mc2-coruna/LACNLC-PistaBaile/Previos Pista Baile/Pista de baile/Montaje.jpg

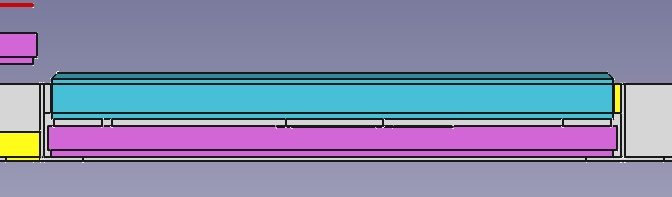
Previos Pista Baile/Pista de baile/Montaje.jpg
