mc2-coruna/LACNLC-PistaBaile/Previos Pista Baile/Pista de baile/Montaje.tif

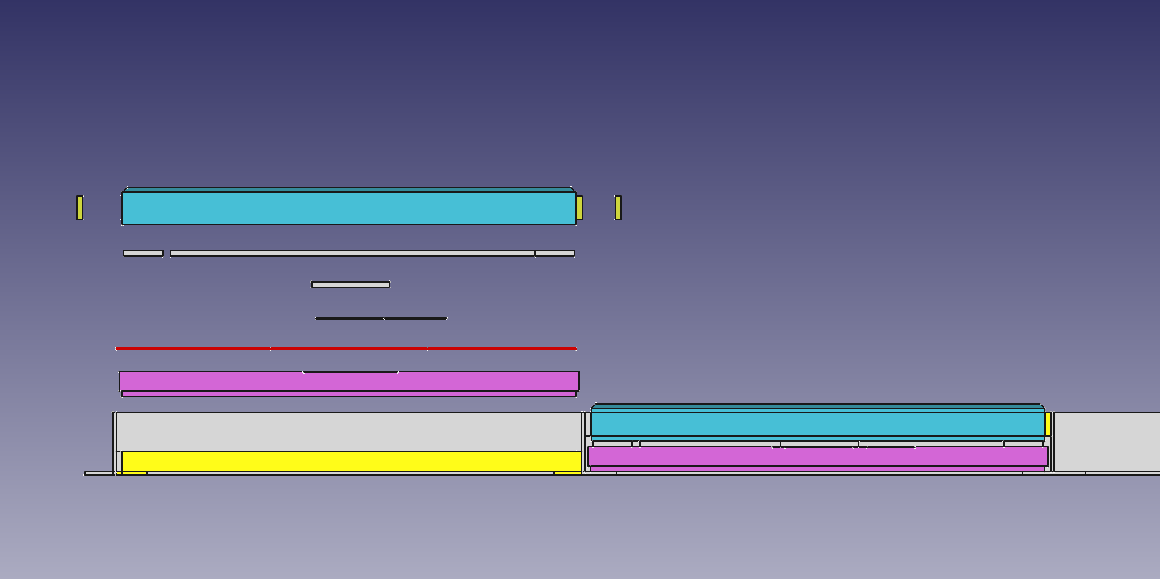
Previos Pista Baile/Pista de baile/Montaje.tif
