mc2-coruna/LACNLC-PistaBaile/README.md

# PistaBaile
Módulo bailón detector de rayos cósmicos
