mc2-coruna/LACNLC-PistaBaile/• Pista Baile_final/Detector_Rayos_Cosmicos/Referencias Detectores Geiger.md

Hodoscopio de 18 tubos: http://www.hardhack.org.au/cosmic_ray_telescope

Un poco de teoría: http://hardhack.org.au/book/export/html/2
        http://www.gae.ucm.es/fisica/report.html

No estamos solos: Detector realizado en Makespace Madrid: http://www.manualsupervivenciamaker.com/manual/inspiracion_electronica_detector_audiovisual_de_radiactividad.html

Página de compra tubos Geiger: Russian Geiger Counter CI-22G SI-22G.pdf
Página de compra fuente de alimentación Geiger: Geiger counter power supply module .pdf
