mc2-coruna/LACNLC-PistaBaile/Previos Pista Baile/Pista de baile/Plano ranura.pdf

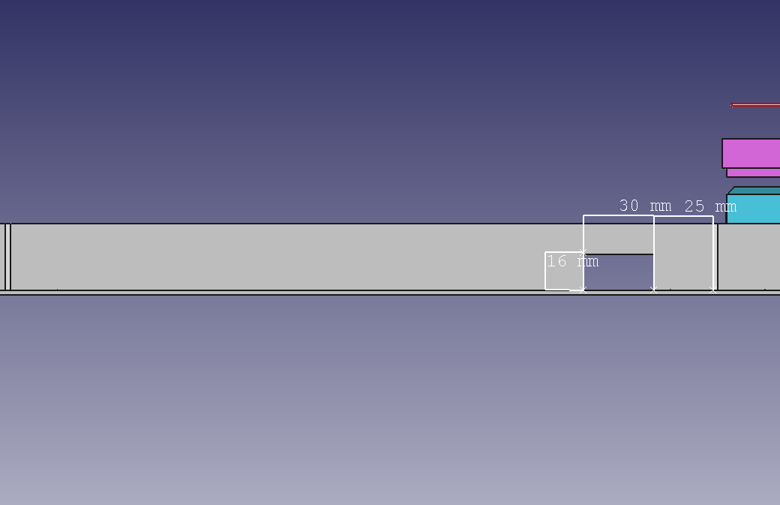
[picture p3: page 1]
