mc2-coruna/LACNLC-PistaBaile/• Pista Baile_final/Arduino/Módulo Bluetooth HC-05 configuración Master_Slave a través de Arduino Nano. - Crisalctime.pdf

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

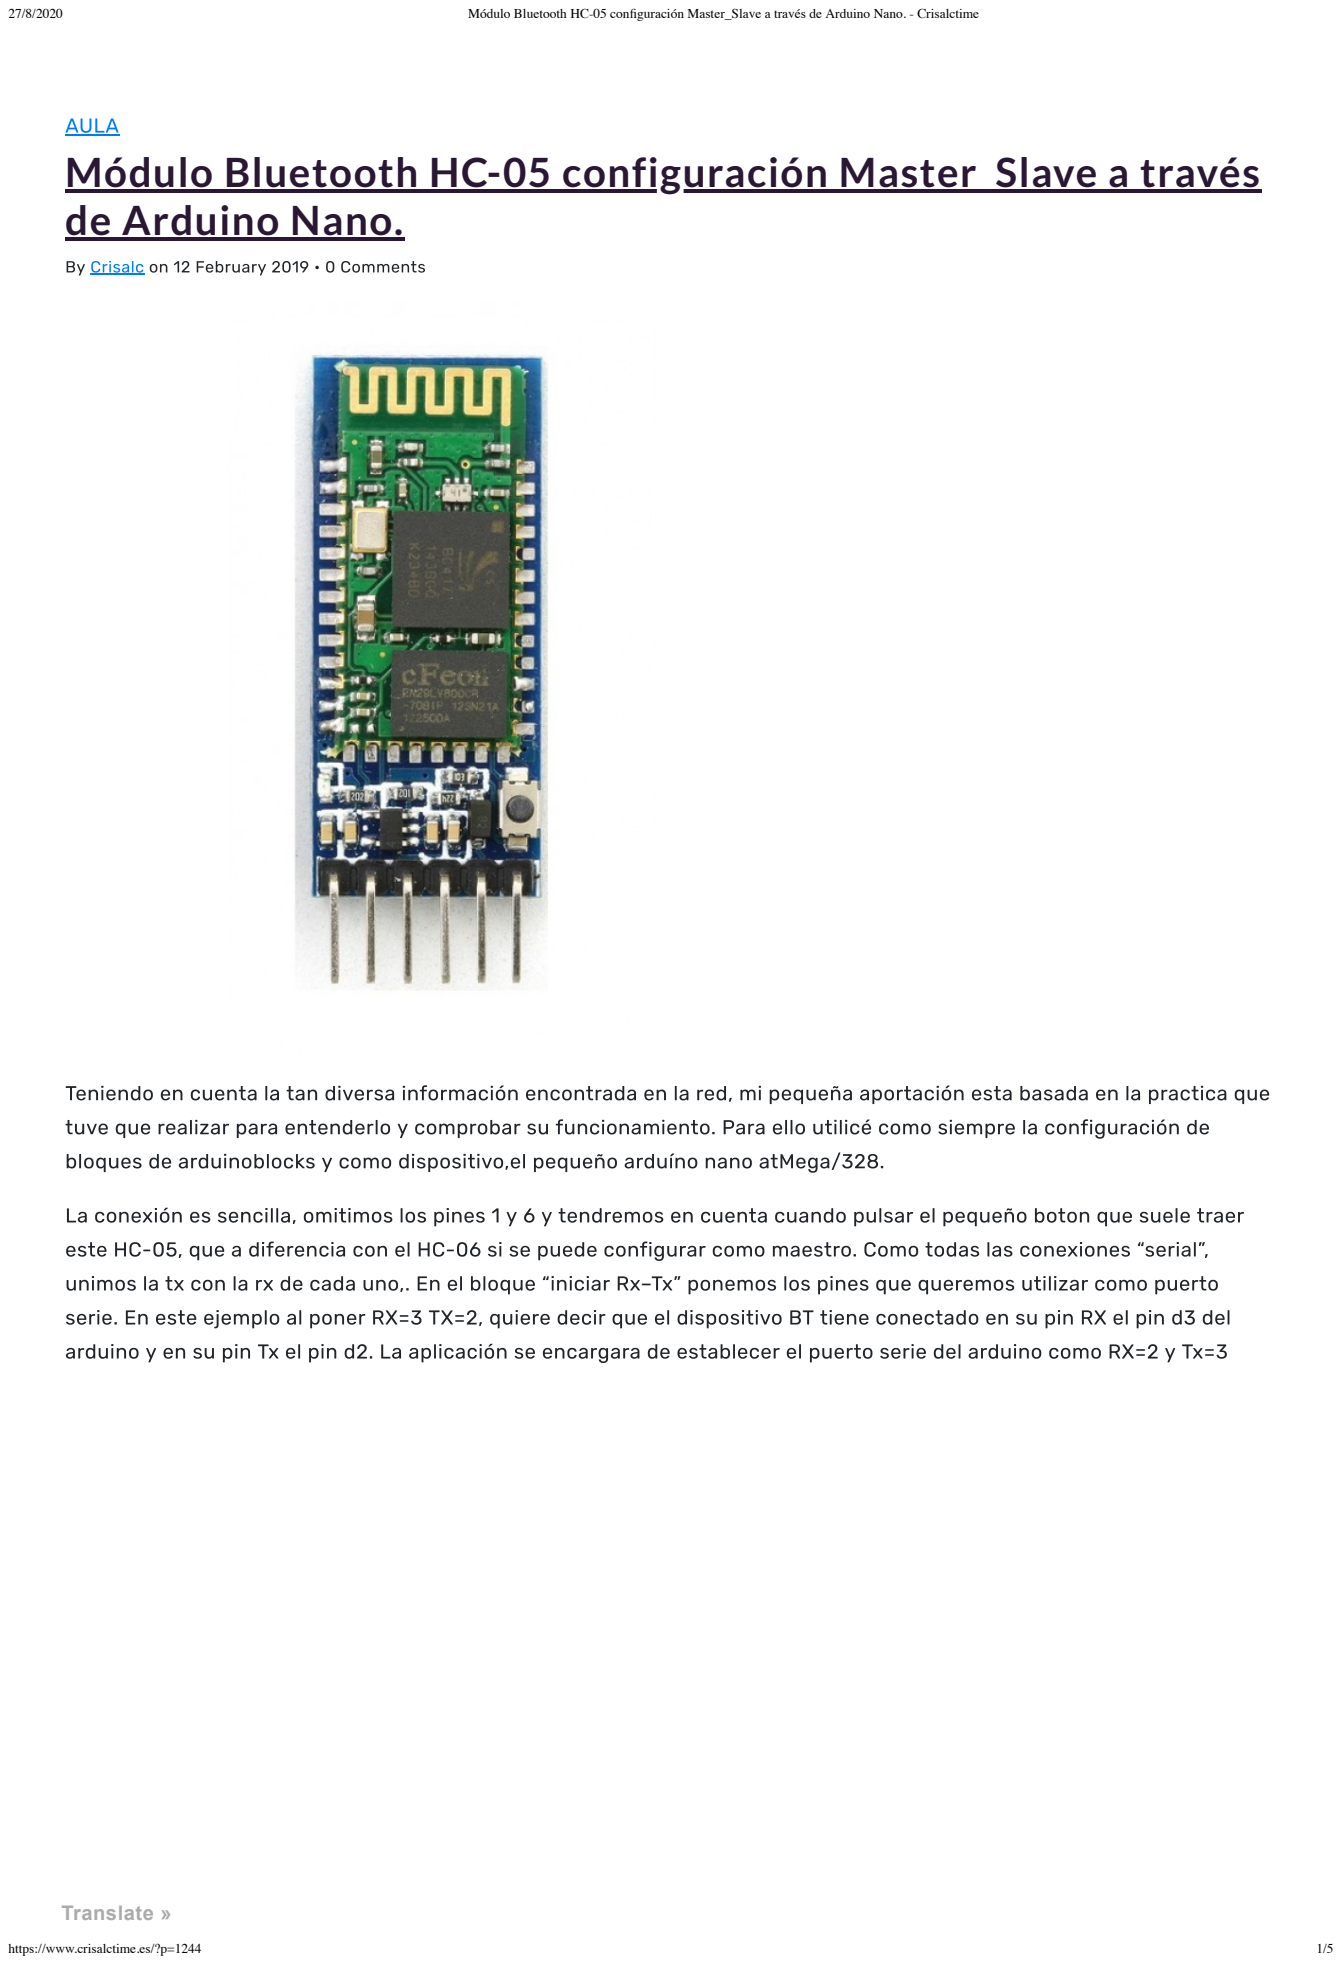
[picture p4: page 1]

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

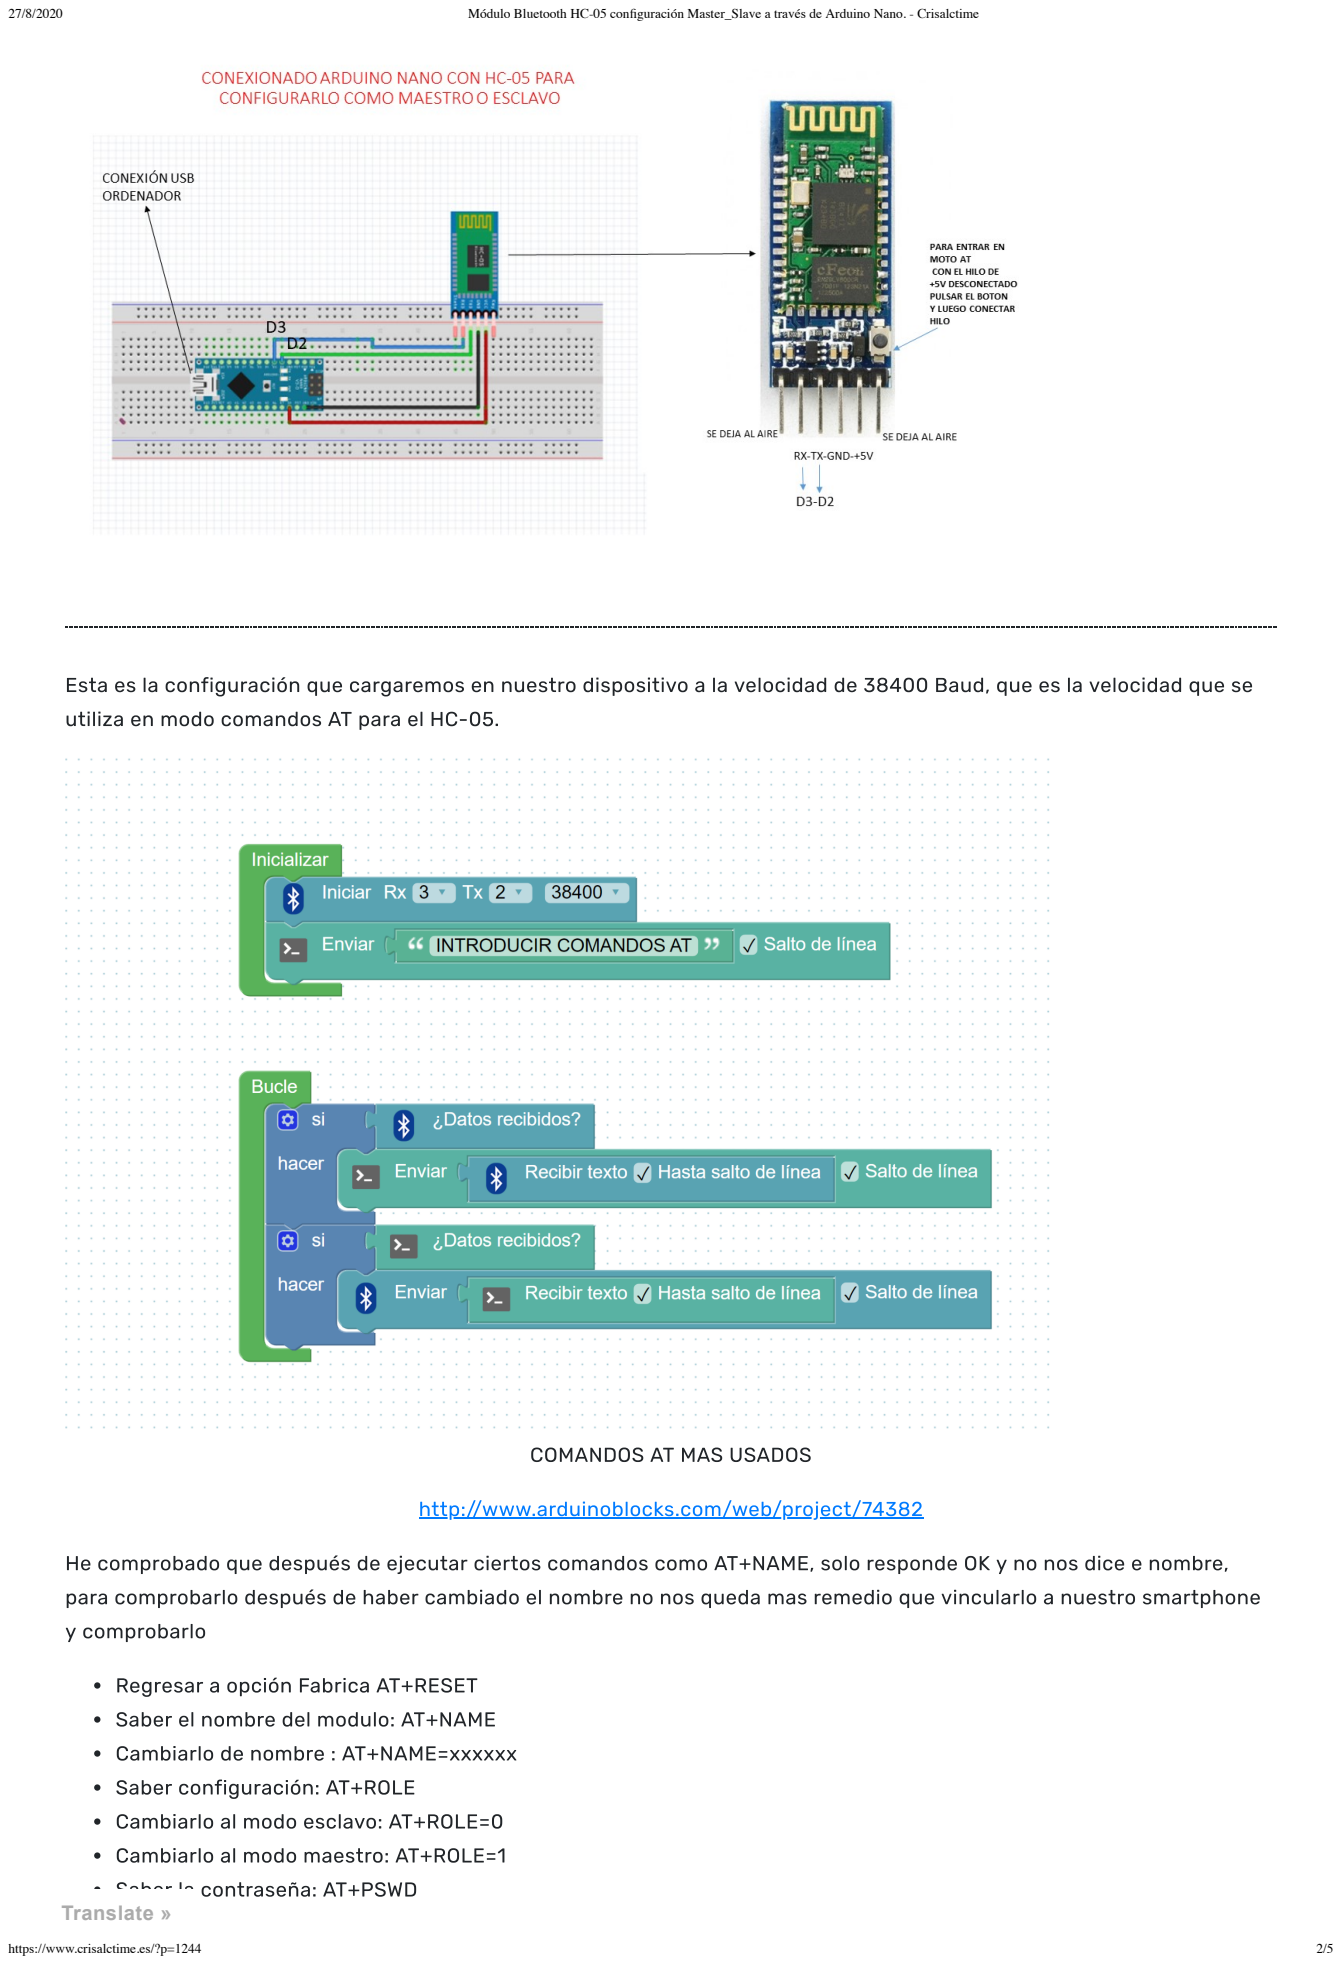
[picture p5: page 2]

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

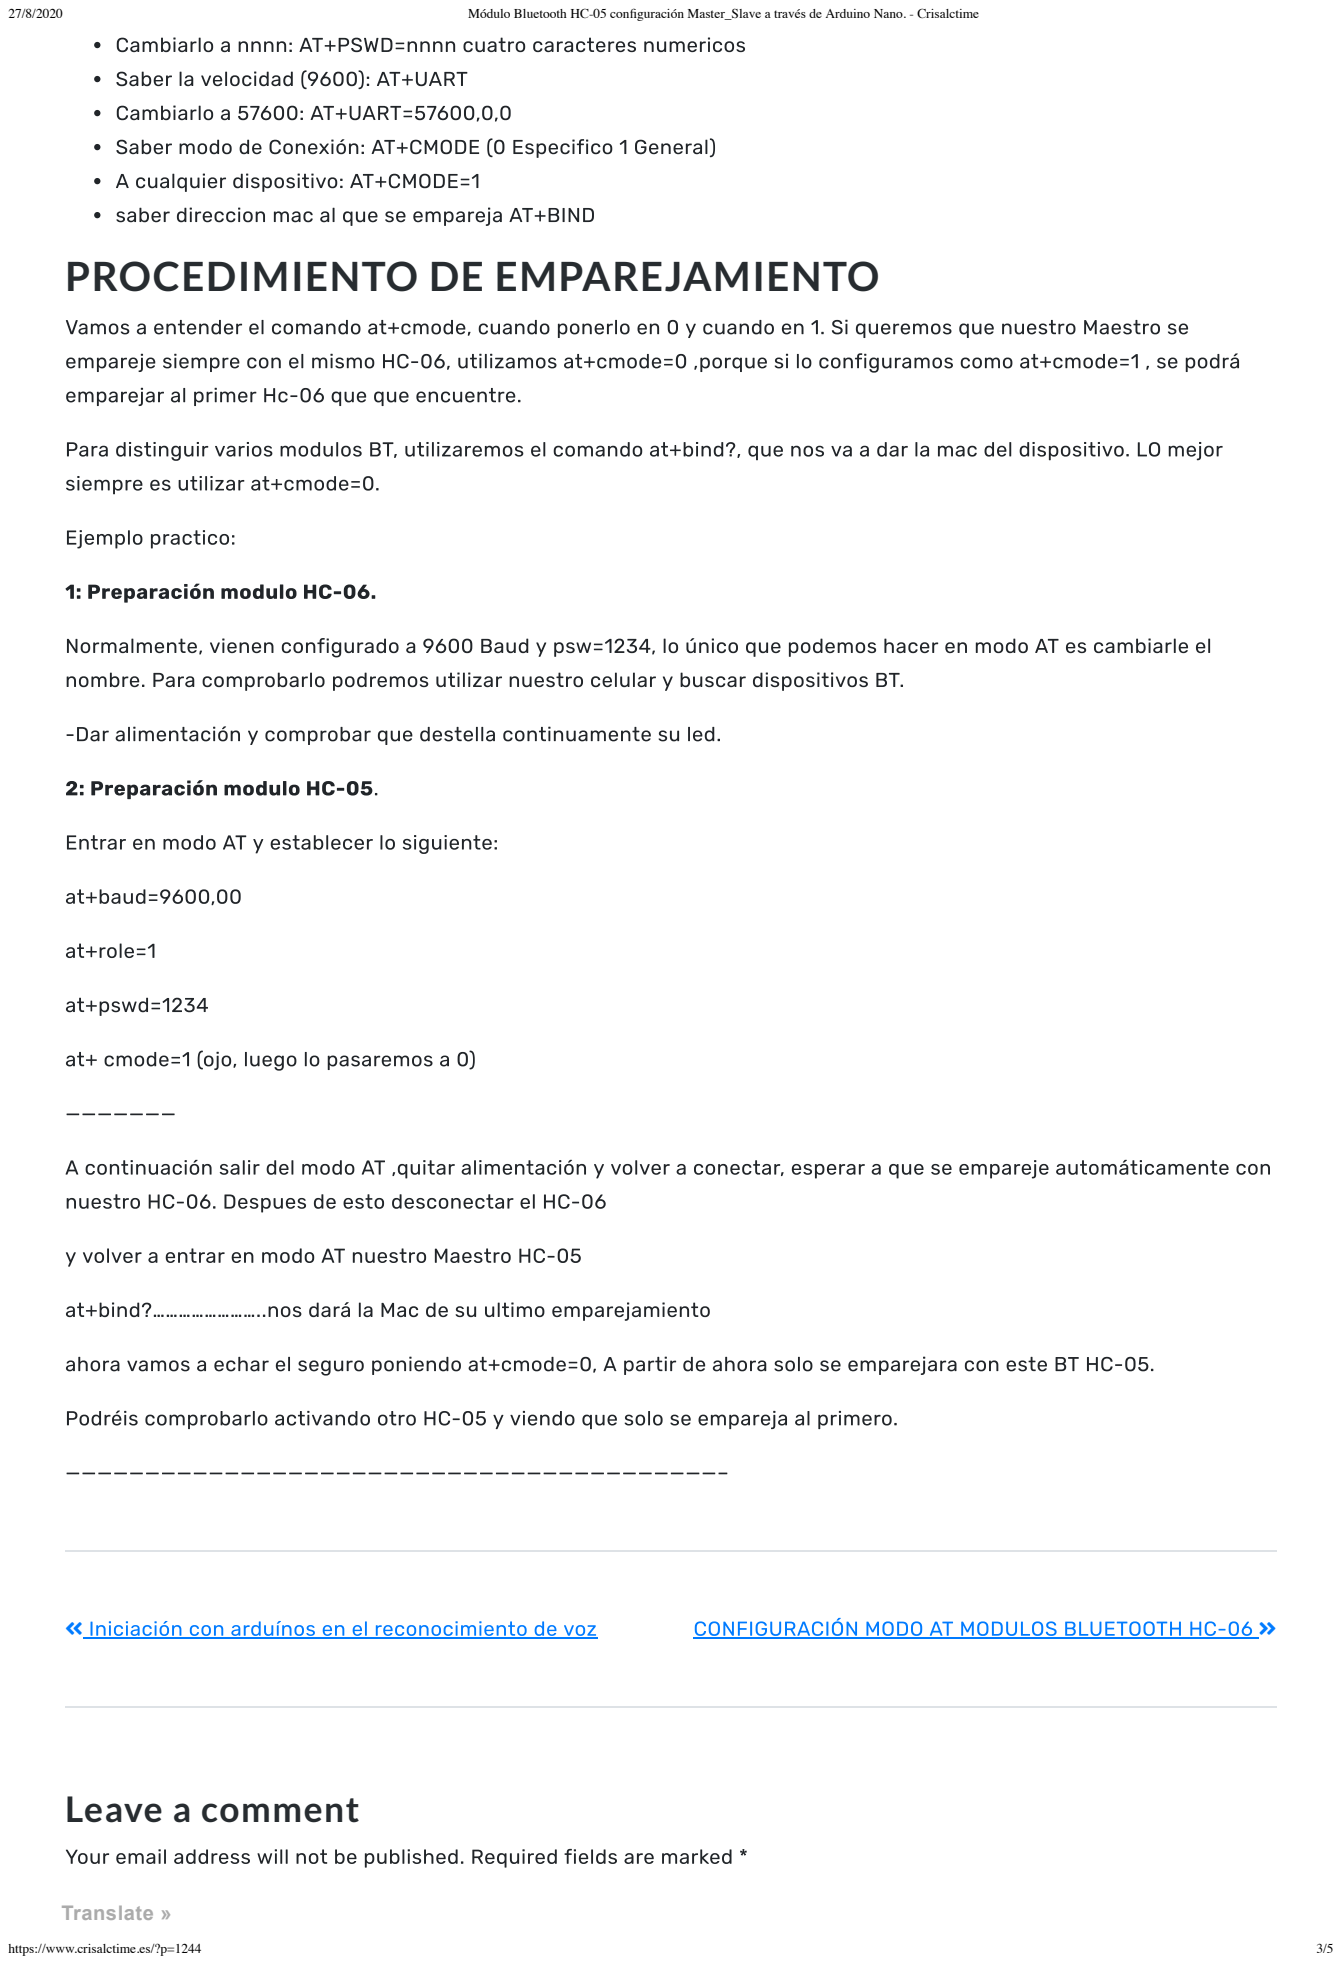
[picture p6: page 3]
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
