mc2-coruna/LACNLC-PistaBaile/Previos Pista Baile/Electrónica/2016-11-28 Placa Geigers/PCB tubos mod inferior.png

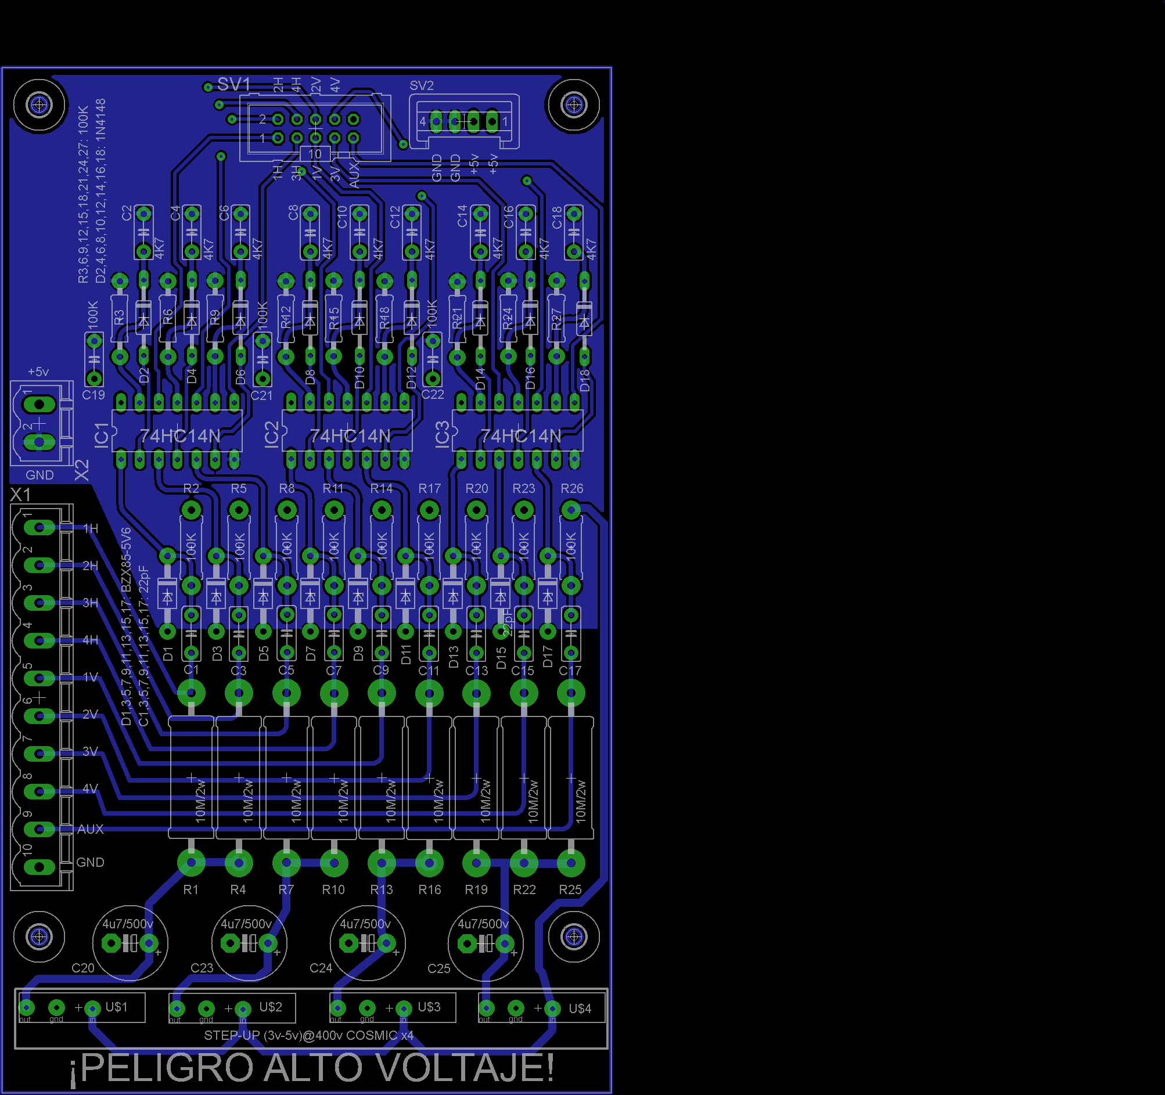
Previos Pista Baile/Electrónica/2016-11-28 Placa Geigers/PCB tubos mod inferior.png
