mc2-coruna/LACNLC-PistaBaile/Previos Pista Baile/Electrónica/2016-11-28 Placa Geigers/PCB tubos mod superior.png

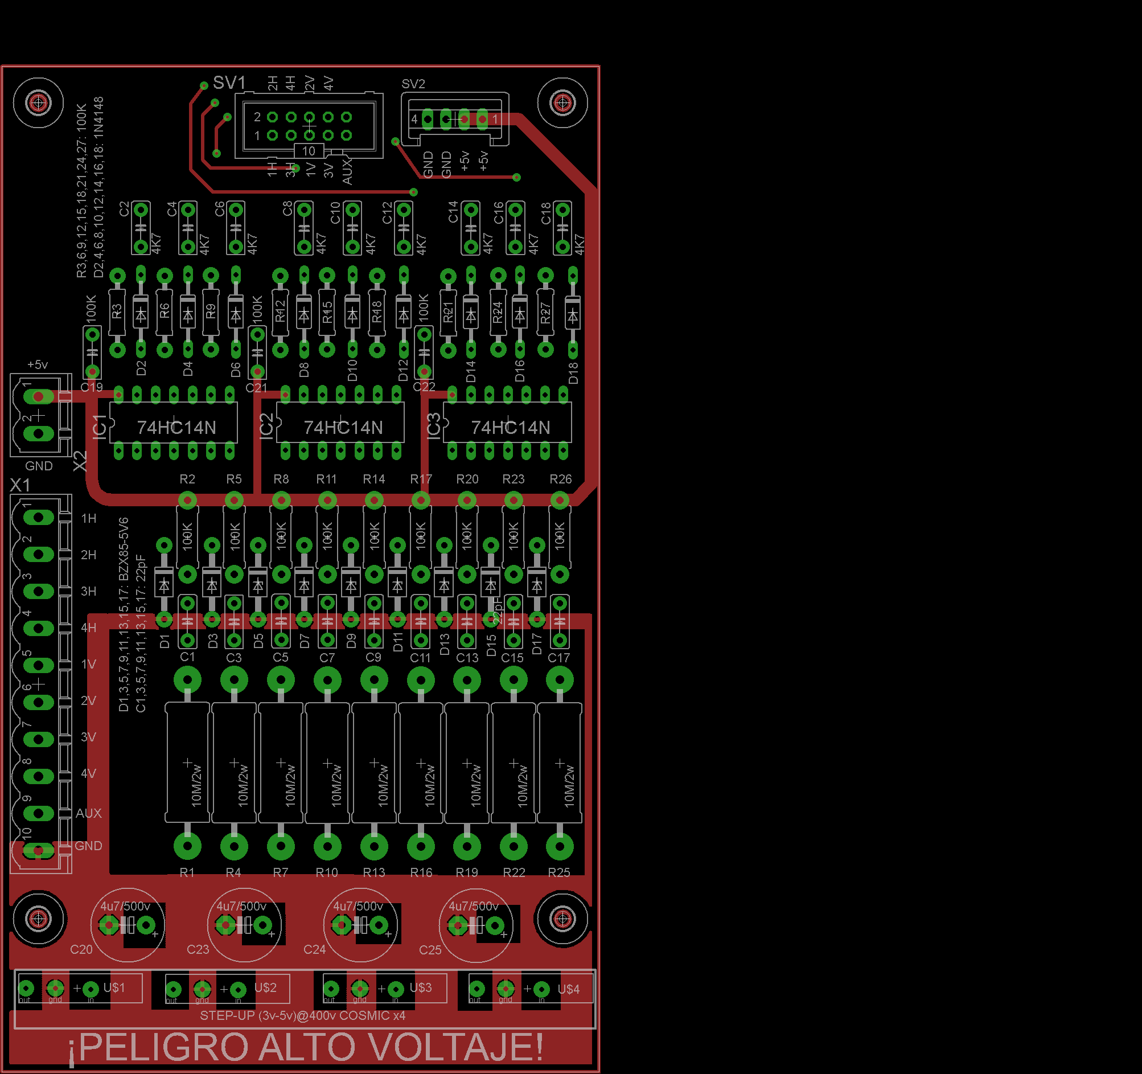
Previos Pista Baile/Electrónica/2016-11-28 Placa Geigers/PCB tubos mod superior.png
