mc2-coruna/LACNLC-PistaBaile/Previos Pista Baile/Electrónica/2016-11-28 Placa LEDs/PCB LED mod superior.png

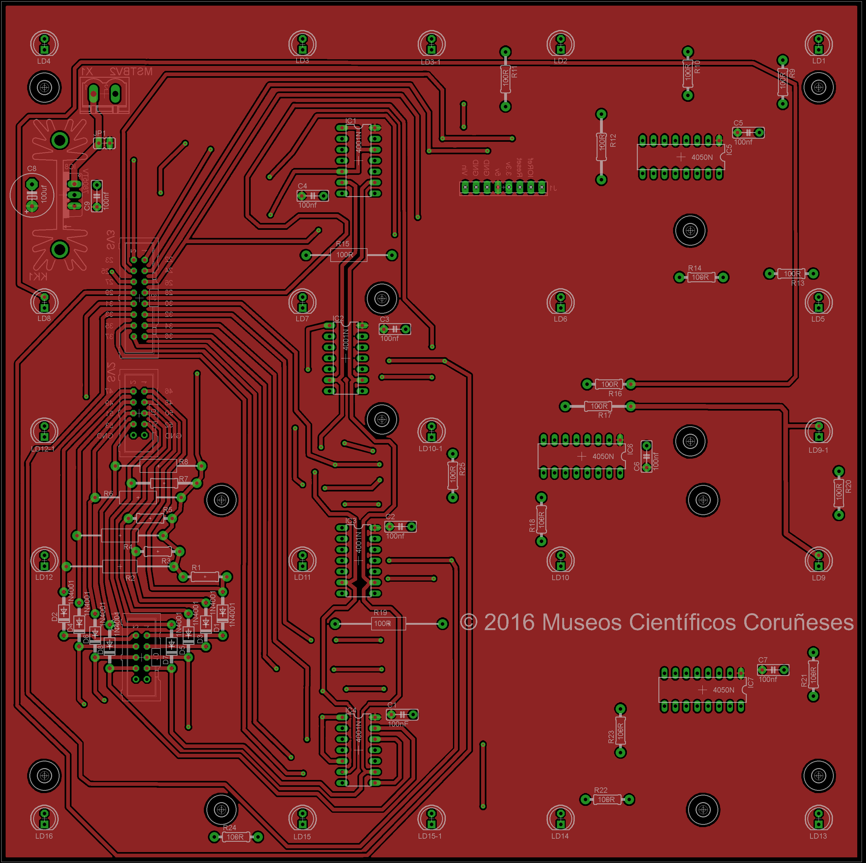
Previos Pista Baile/Electrónica/2016-11-28 Placa LEDs/PCB LED mod superior.png
