mc2-coruna/LACNLC-PistaBaile/Previos Pista Baile/Electrónica/2017-03-20 Placa control suelo/Esquema_control_suelo.png

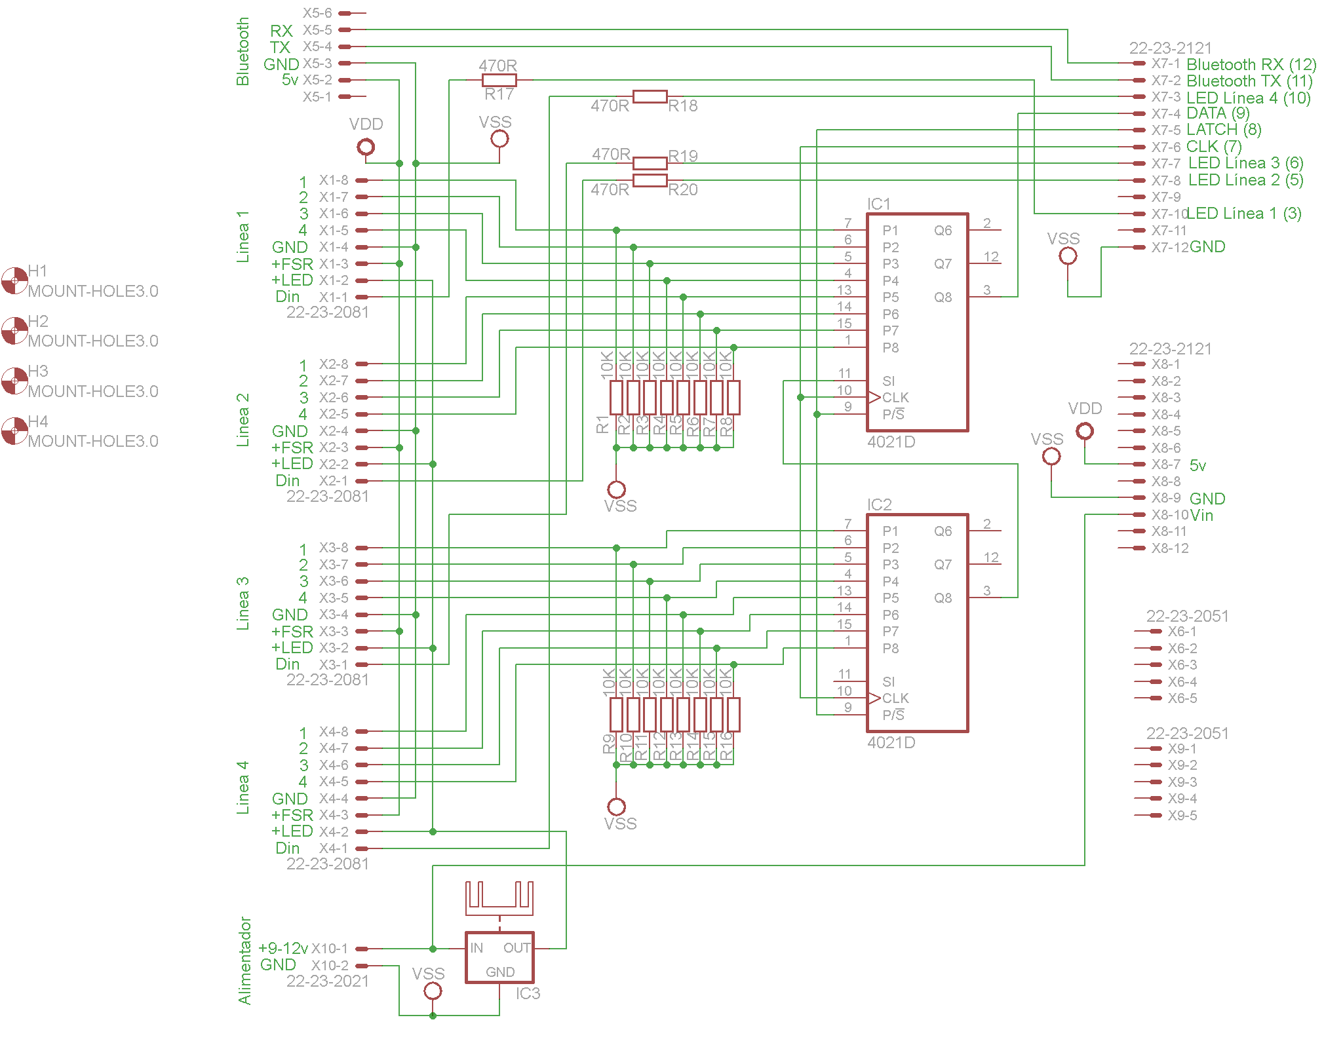
Previos Pista Baile/Electrónica/2017-03-20 Placa control suelo/Esquema_control_suelo.png
