mc2-coruna/LACNLC-PistaBaile/Previos Pista Baile/Electrónica/2017-03-20 Placa control suelo/PCB_control_suelo_superior.png

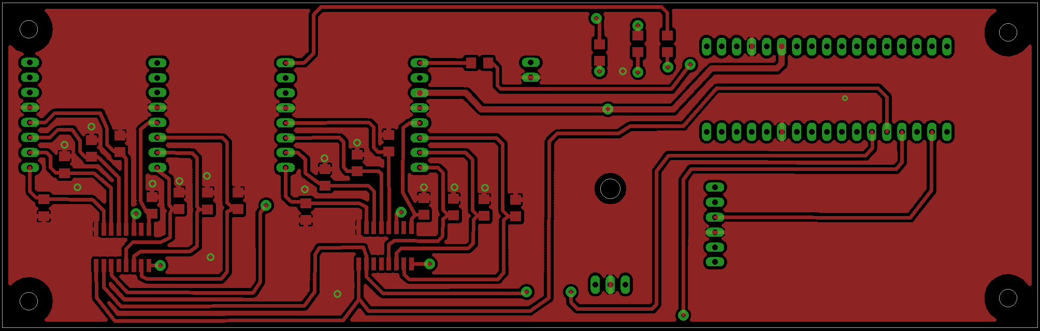
Previos Pista Baile/Electrónica/2017-03-20 Placa control suelo/PCB_control_suelo_superior.png
