mc2-coruna/LACNLC-PistaBaile/Previos Pista Baile/Electrónica/2017-03-22 Placa cableado suelo/Esquema_cableado_suelo.png

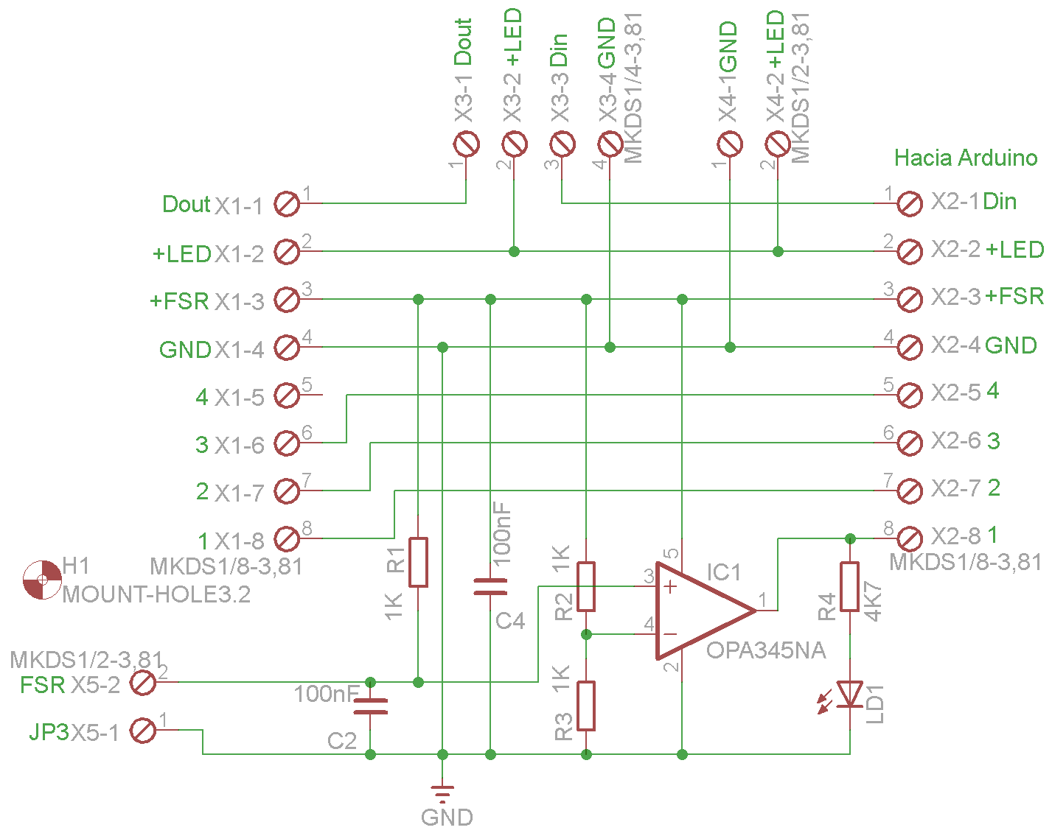
Previos Pista Baile/Electrónica/2017-03-22 Placa cableado suelo/Esquema_cableado_suelo.png
