mc2-coruna/LACNLC-PistaBaile/Previos Pista Baile/Electrónica/2017-03-22 Placa cableado suelo/PCB_Cableado_suelo_inferior.png

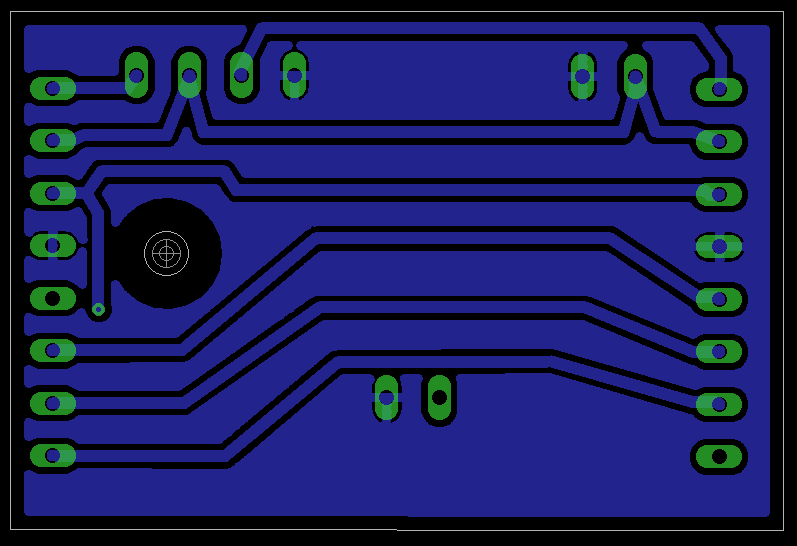
Previos Pista Baile/Electrónica/2017-03-22 Placa cableado suelo/PCB_Cableado_suelo_inferior.png
