mc2-coruna/LACNLC-PistaBaile/Previos Pista Baile/Pista de baile/axonometrica.jpg

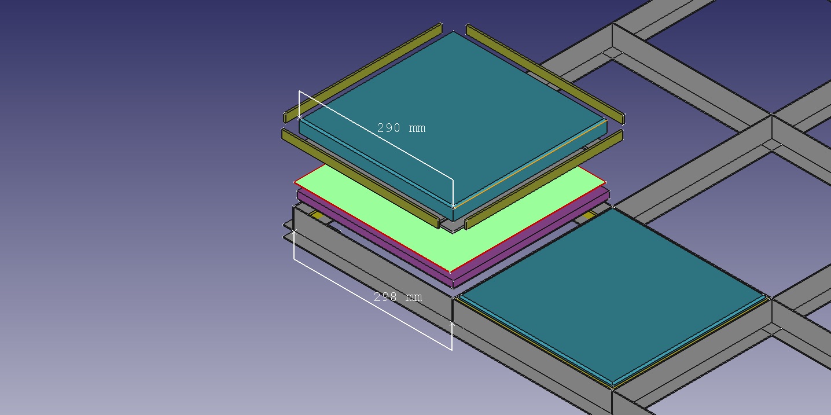
Previos Pista Baile/Pista de baile/axonometrica.jpg
