mc2-coruna/LACNLC-PistaBaile/Previos Pista Baile/Pista de baile/Bastidor.jpg

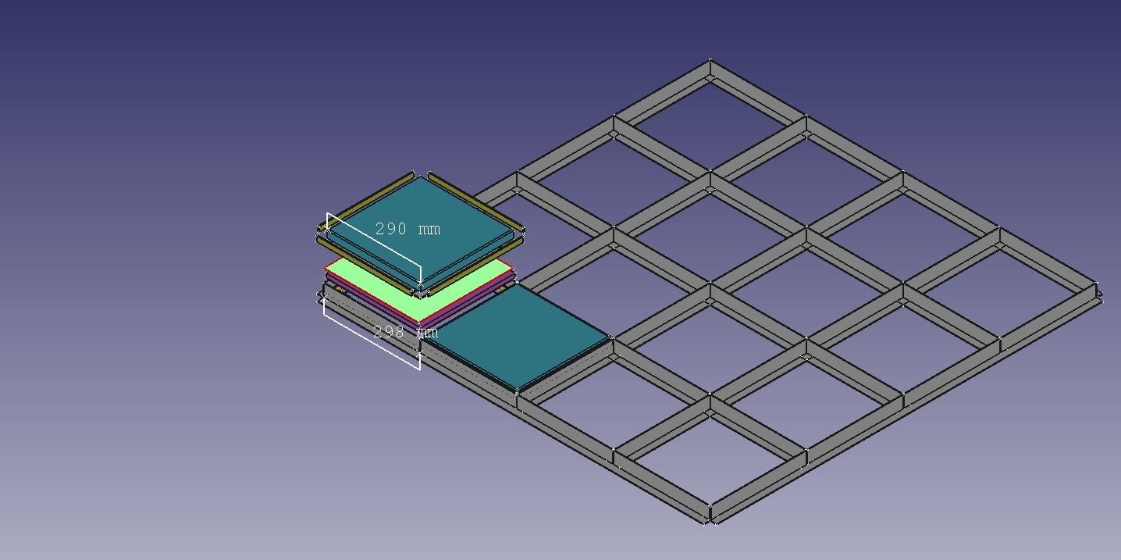
Previos Pista Baile/Pista de baile/Bastidor.jpg
