mc2-coruna/LACNLC-PistaBaile/Previos Pista Baile/Pista de baile/Despiece.jpg

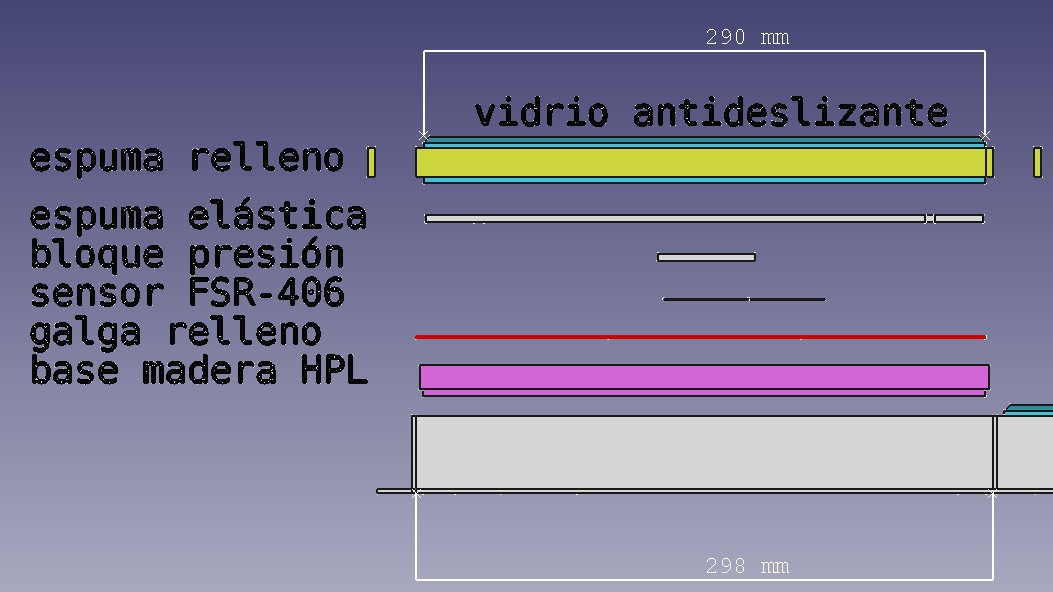
Previos Pista Baile/Pista de baile/Despiece.jpg
