mc2-coruna/LACNLC-PistaBaile/Previos Pista Baile/Pista de baile/despiece.tif

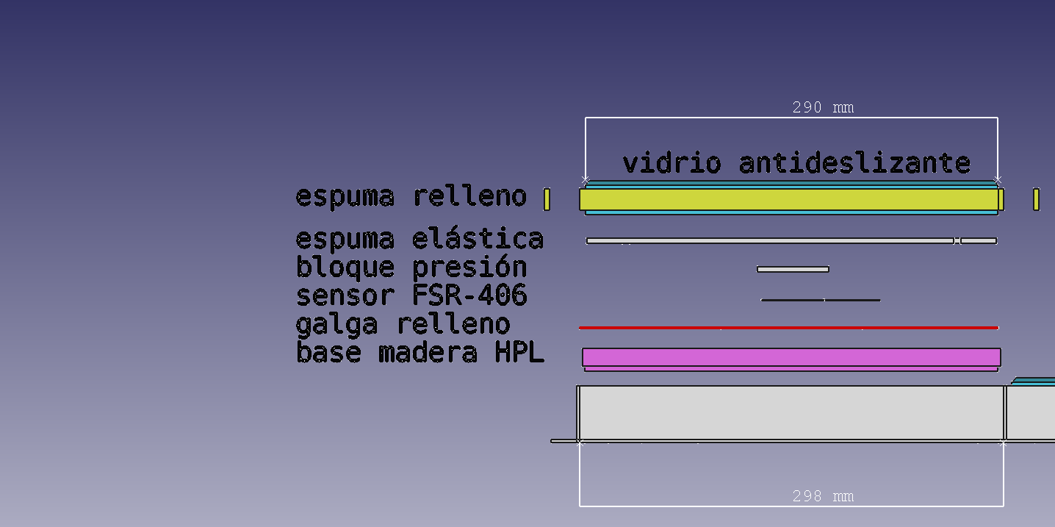
Previos Pista Baile/Pista de baile/despiece.tif
