mc2-coruna/LACNLC-PistaBaile/Previos Pista Baile/Pista de baile/Pista Baile.FCStd

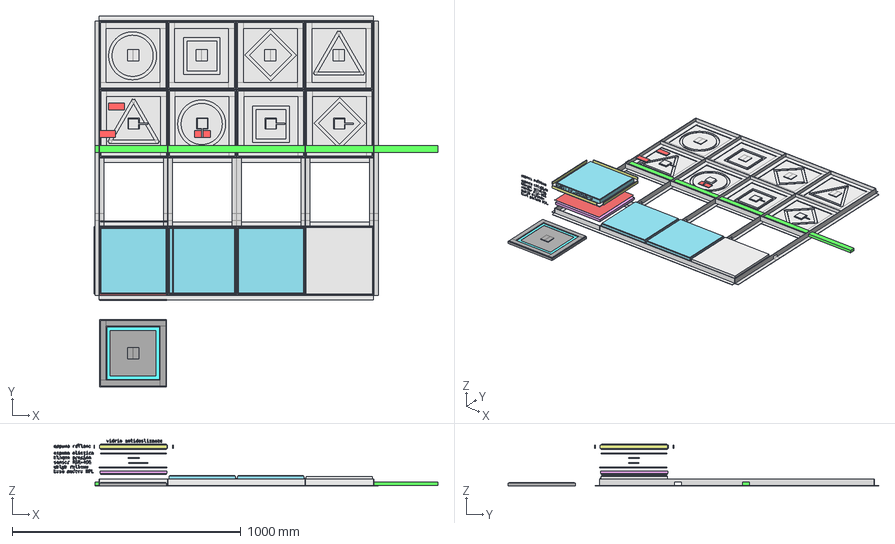
[picture p25: CAD file, 2020-08-27]
Previos Pista Baile/Pista de baile/Pista Baile.FCStd
1678.8 x 1620.0 x 204.5 mm
Espuma amortiguacion
Espuma presión
FSR 406-2
DM recortado
DM recortado001
FSR 406-1
Espuma presión001
Espuma amortiguacion001
Espuma lateral001
Espuma cierre lateral
Vidrio002
Espuma relleno
Galga
Espuma elástica
Espuma elástica001
Sensor
Galga relleno
Madera base
Espuma lateral002
DM recortado002
FSR 406-003
Espuma presión002
Espuma amortiguacion002
DM recortado003
Vidrio004
Espuma amortiguacion003
FSR 406-004
Espuma lateral003
Espuma presión003
Bandosa cuadrado
Corte LED cuadrado
Bandosa cuadrado_no
Baldosa rombo_
Baldosa triángulo_
Baldosa círculo_
Baldosa círculo_001
Baldosa cuadrado_001
Baldosa rombo_001
Baldosa triángulo_001
Baldosa cuadrado_002
Circuito Impreso_001
FSR 406-005
Canal
FSR 406-006
Circuito Impreso_002
Circuito Impreso_003
FSR 406-007
Circuito Impreso_004
FSR 406-008
