mc2-coruna/LACNLC-PistaBaile/(list of files, drawings)

Other design files:
Previos Pista Baile/Pista de baile/Placa cableado.fzz
