mc2-coruna/LACNLC-PistaBaile/Previos Pista Baile/2017-03-02 Pruebas MIDI/MP3_Player_Shield-V_1.5/hardware/SparkFunMP3Shield.brd

## EAGLE design Previos Pista Baile/2017-03-02 Pruebas MIDI/MP3_Player_Shield-V_1.5/hardware/SparkFunMP3Shield.brd (2020-08-27)

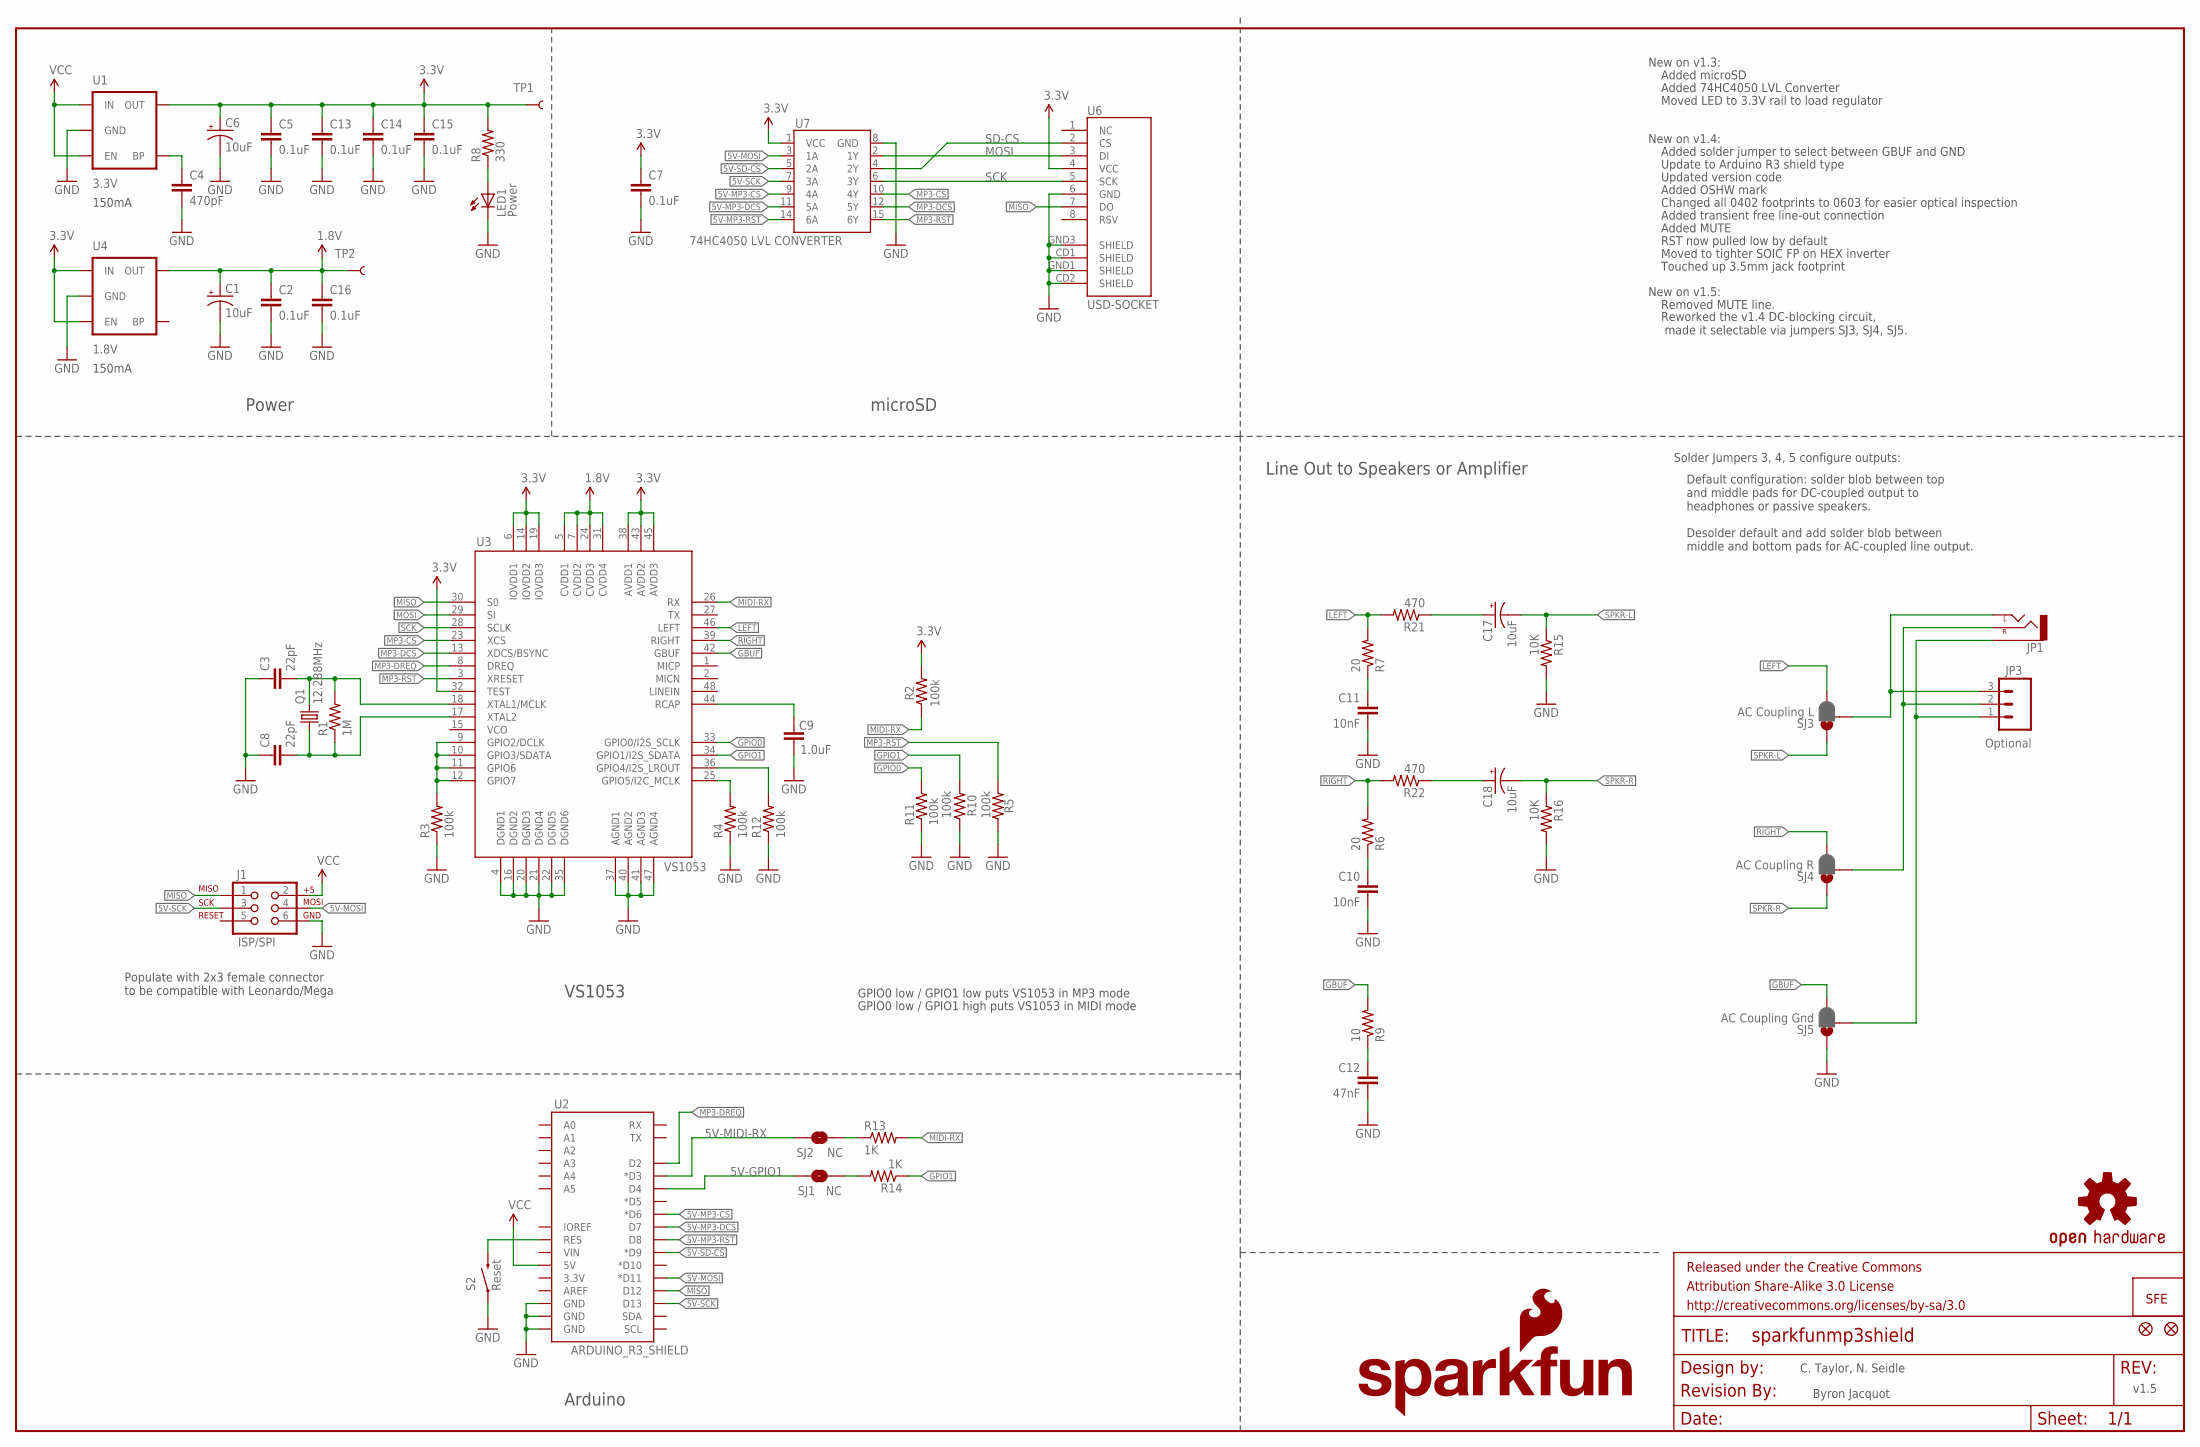
[picture p28: schematic SparkFunMP3Shield.sch]

Parts:
C1, C6, C17, C18: 10uF; EIA3216
C2, C5, C7, C13, C14, C15, C16: 0.1uF; 0603-CAP
C3, C8: 22pF; 0603-CAP
C4: 470pF; 0603-CAP
C9: 1.0uF; 0603-CAP
C10, C11: 10nF; 0603-CAP
C12: 47nF; 0603-CAP
FRAME1: FRAME-LEDGER; CREATIVE_COMMONS
J1: ISP/SPI; 2X3
JP1: AUDIO-JACKSMD2; AUDIO-JACK-3.5MM-SMD
JP3: Optional; 1X03
LED1: Power; LED-0603
LOGO1: OSHW-LOGOS; OSHW-LOGO-S
LOGO2: SFE_LOGO_NAME_FLAME.1_INCH; SFE_LOGO_NAME_FLAME_.1
Q1: 12.288MHz; CRYSTAL-SMD-5X3
R1: 1M; 0603-RES
R2, R3, R4, R5, R10, R11, R12: 100k; 0603-RES
R6, R7: 20; 0603-RES
R8: 330; 0603-RES
R9: 10; 0603-RES
R13, R14: 1K; 0603-RES
R15, R16: 10K; 0603-RES
R21, R22: 470; 0603-RES
S2: Reset; TACTILE_SWITCH_SMD
SJ1, SJ2: NC; SJ_2S-TRACE
SJ3: AC Coupling L; PAD-JUMPER-3-2OF3_NC_BY_PASTE_YES_SILK_FULL_BOX
SJ4: AC Coupling R; PAD-JUMPER-3-2OF3_NC_BY_PASTE_YES_SILK_FULL_BOX
SJ5: AC Coupling Gnd; PAD-JUMPER-3-2OF3_NC_BY_PASTE_YES_SILK_FULL_BOX
TP1, TP2: TEST-POINT3X5; PAD.03X.05
U1: 3.3V; SOT23-5
U2: ARDUINO_R3_SHIELD; UNO_R3_SHIELD
U3: VS1053; LQFP-48
U4: 1.8V; SC70
U6: USD-SOCKET; MICRO-SD-SOCKET-PP
U7: 74HC4050 LVL CONVERTER; SO016
U$1: REVISION
U$4, U$5: FIDUCIAL1X2; FIDUCIAL-1X2
U$8: LOGO-SFENEW; SFE-NEW-WEBLOGO

Connections:
1.8V: C1.A (+), C2.1, C16.1, TP2.P$1, U3.5 (CVDD1), U3.7 (CVDD2), U3.24 (CVDD3), U3.31 (CVDD4), U4.5 (OUT)
3.3V: C5.1, C6.A (+), C7.1, C13.1, C14.1, C15.1, R2.2, R8.2, TP1.P$1, U1.5 (OUT), U3.6 (IOVDD1), U3.14 (IOVDD2), U3.19 (IOVDD3), U3.32 (TEST), U3.38 (AVDD1), U3.43 (AVDD2), U3.45 (AVDD3), U4.1 (IN), U4.3 (EN), U6.4 (VCC), U7.1 (VCC)
5V-GPIO1: SJ1.2, U2.D4
5V-MIDI-RX: SJ2.1, U2.D3 (*D3)
5V-MOSI: J1.4, U2.D11 (*D11), U7.3 (1A)
5V-MP3-CS: U2.D6 (*D6), U7.9 (4A)
5V-MP3-DCS: U2.D7, U7.11 (5A)
5V-MP3-RST: U2.D8, U7.14 (6A)
5V-SCK: J1.3, U2.D13, U7.7 (3A)
5V-SD-CS: U2.D9 (*D9), U7.5 (2A)
ARST: S2.3 (2), U2.RES
G1: R3.2, U3.9 (GPIO2/DCLK), U3.10 (GPIO3/SDATA), U3.11 (GPIO6), U3.12 (GPIO7)
G2: R4.2, U3.25 (GPIO5/I2C_MCLK)
GBUF: R9.2, SJ5.3, U3.42 (GBUF)
GND: C1.C (-), C2.2, C3.1, C4.2, C5.2, C6.C (-), C7.2, C8.1, C9.1, C10.2, C11.2, C12.2, C13.2, C14.2, C15.2, C16.2, J1.6, LED1.C, R3.1, R4.1, R5.1, R10.1, R11.1, R12.1, R15.2, R16.2, S2.1, SJ5.1, U1.2 (GND), U2.GND@0 (GND), U2.GND@1 (GND), U2.GND@2 (GND), U3.4 (DGND1), U3.16 (DGND2), U3.20 (DGND3), U3.21 (DGND4), U3.22 (DGND5), U3.35 (DGND6), U3.37 (AGND1), U3.40 (AGND2), U3.41 (AGND3), U3.47 (AGND4), U4.2 (GND), U6.6 (GND), U6.CD1 (SHIELD), U6.CD2 (SHIELD), U6.GND1 (SHIELD), U6.GND3 (SHIELD), U7.8 (GND)
GPIO0: R11.2, U3.33 (GPIO0/I2S_SCLK)
GPIO1: R10.2, R14.1, U3.34 (GPIO1/I2S_SDATA)
GPIO4: R12.2, U3.36 (GPIO4/I2S_LROUT)
LEFT: R7.2, R21.2, SJ3.3, U3.46 (LEFT)
MIDI-RX: R2.1, R13.2, U3.26 (RX)
MISO: J1.1, U2.D12, U3.30 (S0), U6.7 (DO)
MOSI: U3.29 (SI), U6.3 (DI), U7.2 (1Y)
MP3-CS: U3.23 (XCS), U7.10 (4Y)
MP3-DCS: U3.13 (XDCS/BSYNC), U7.12 (5Y)
MP3-DREQ: U2.D2, U3.8 (DREQ)
MP3-RST: R5.2, U3.3 (XRESET), U7.15 (6Y)
unnamed: C12.1, R9.1
unnamed: C10.1, R6.1
unnamed: R14.2, SJ1.1
unnamed: C11.1, R7.1
unnamed: LED1.A, R8.1
unnamed: R13.1, SJ2.2
unnamed: C3.2, Q1.3 (2), R1.2, U3.18 (XTAL1/MCLK)
unnamed: C8.2, Q1.1, R1.1, U3.17 (XTAL2)
unnamed: JP1.SLEEVE, JP3.1, SJ5.2
unnamed: JP1.RING (RIGHT), JP3.2, SJ4.2
unnamed: JP1.TIP (LEFT), JP3.3, SJ3.2
unnamed: C18.A (+), R22.1
unnamed: C17.A (+), R21.1
unnamed: C4.1, U1.4 (BP)
RCAP: C9.2, U3.44 (RCAP)
RIGHT: R6.2, R22.2, SJ4.3, U3.39 (RIGHT)
SCK: U3.28 (SCLK), U6.5 (SCK), U7.6 (3Y)
SD-CS: U6.2 (CS), U7.4 (2Y)
SPKR-L: C17.C (-), R15.1, SJ3.1
SPKR-R: C18.C (-), R16.1, SJ4.1
VCC: J1.2, U1.1 (IN), U1.3 (EN), U2.5V

Notes on the sheet:
GPIO0 low / GPIO1 high puts VS1053 in MIDI mode
C. Taylor, N. Seidle
New on v1.3:
GPIO0 low / GPIO1 low puts VS1053 in MP3 mode
microSD
Power
Line Out to Speakers or Amplifier
Arduino
VS1053
Moved LED to 3.3V rail to load regulator
Added microSD
Added 74HC4050 LVL Converter
New on v1.4:
Added solder jumper to select between GBUF and GND
Default configuration: solder blob between top and middle pads for DC-coupled output to headphones or passive speakers. Desolder default and add solder blob between middle and bottom pads for AC-coupled line output.
Update to Arduino R3 shield type
Updated version code
Added OSHW mark
Changed all 0402 footprints to 0603 for easier optical inspection
Added transient free line-out connection
Added MUTE
Solder Jumpers 3, 4, 5 configure outputs:
150mA
v1.5
RST now pulled low by default
Populate with 2x3 female connector to be compatible with Leonardo/Mega
Moved to tighter SOIC FP on HEX inverter
Touched up 3.5mm jack footprint
Byron Jacquot
New on v1.5:
Removed MUTE line.
Reworked the v1.4 DC-blocking circuit, made it selectable via jumpers SJ3, SJ4, SJ5.

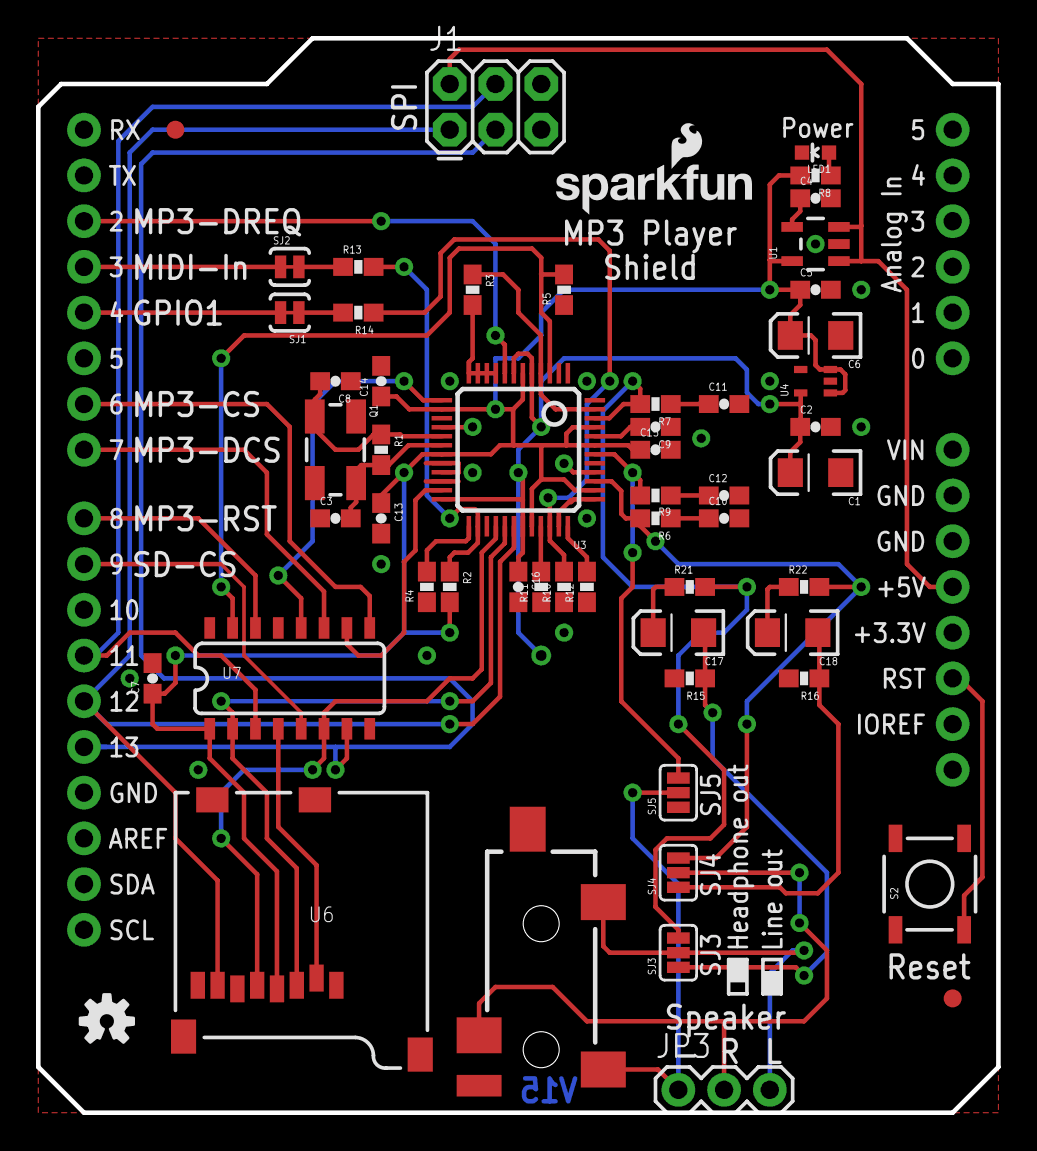
[picture p29: board SparkFunMP3Shield.brd from above]

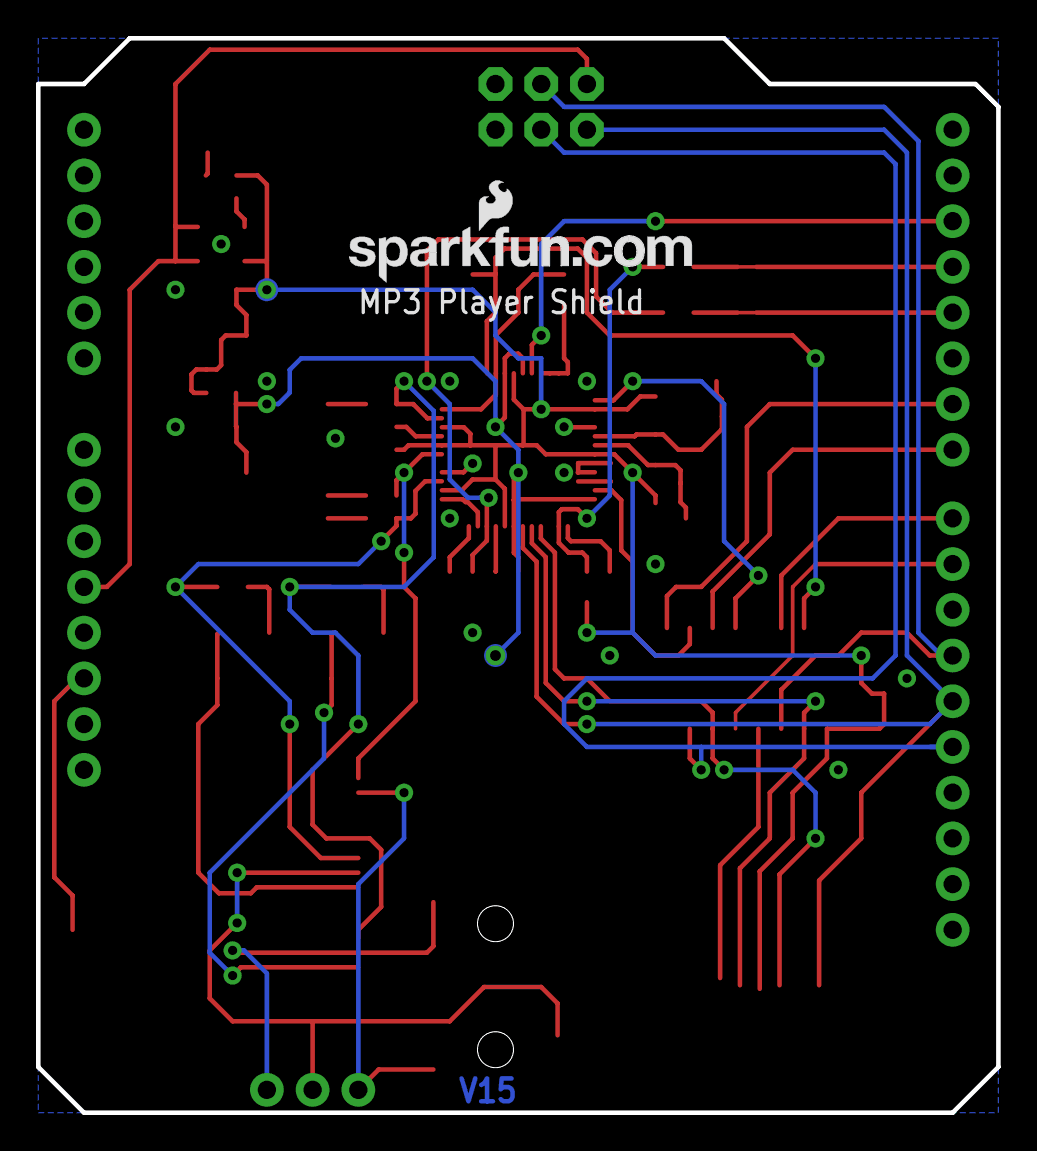
[picture p30: board SparkFunMP3Shield.brd from below]

Board: 2 copper layers, 53.3 x 59.7 mm, 62 parts (3 on the bottom side), 47 nets.
