mc2-coruna/LACNLC-PistaBaile/Previos Pista Baile/2017-03-02 Pruebas MIDI/MP3_Player_Shield-V_1.5/Production/MP3-Shield-Panel-v15.brd

## EAGLE design Previos Pista Baile/2017-03-02 Pruebas MIDI/MP3_Player_Shield-V_1.5/Production/MP3-Shield-Panel-v15.brd (2020-08-27)

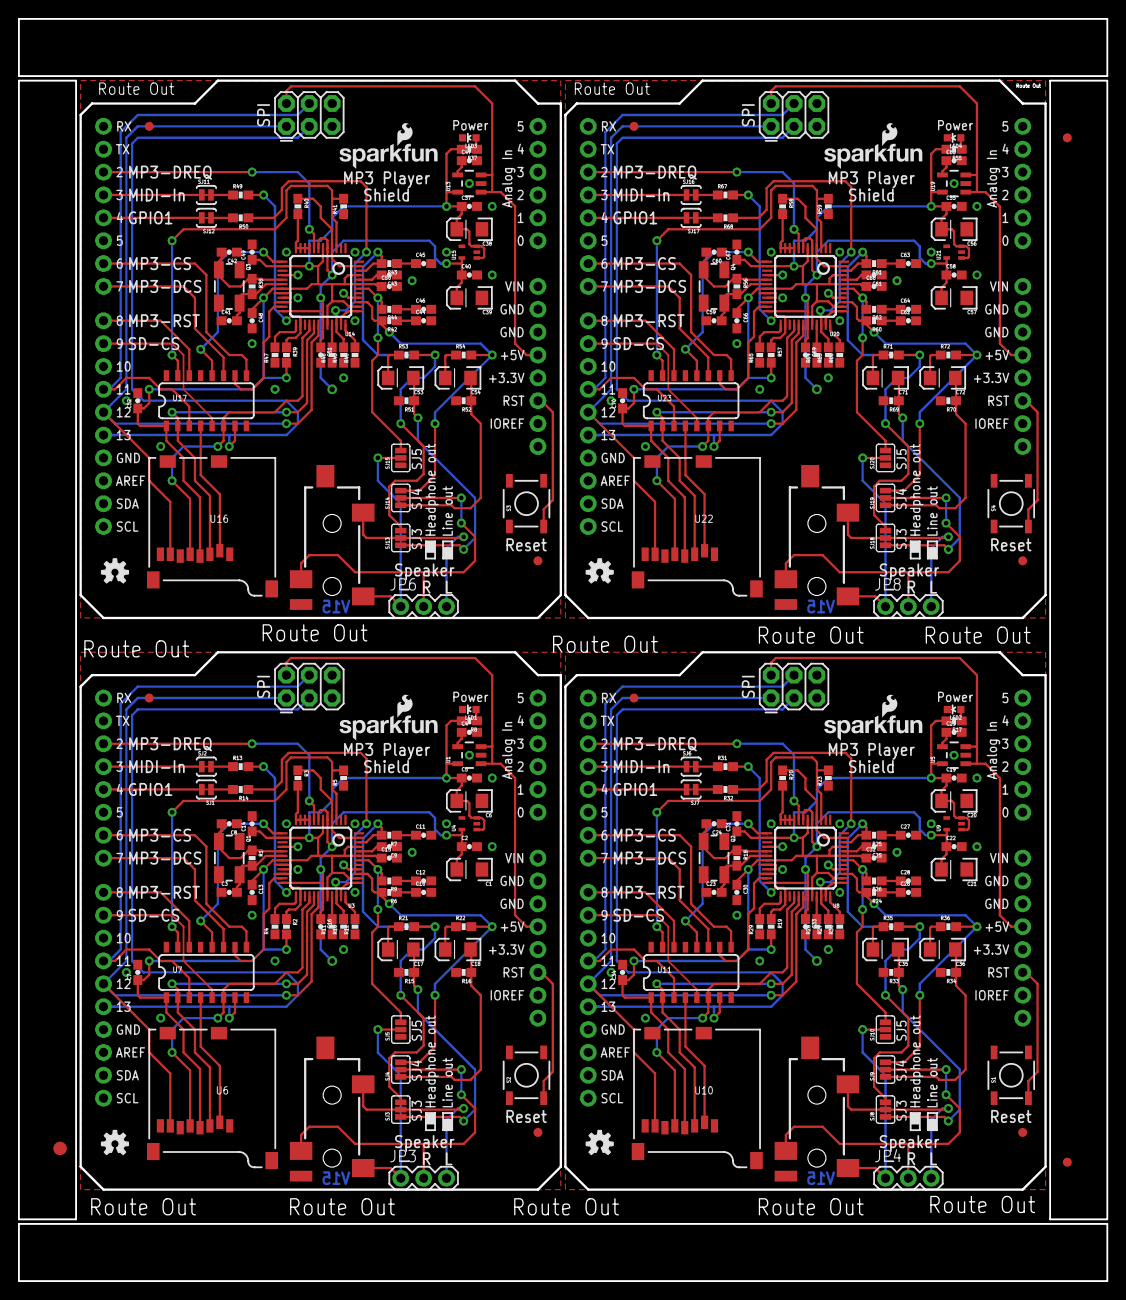
[picture p31: board MP3-Shield-Panel-v15.brd from above]

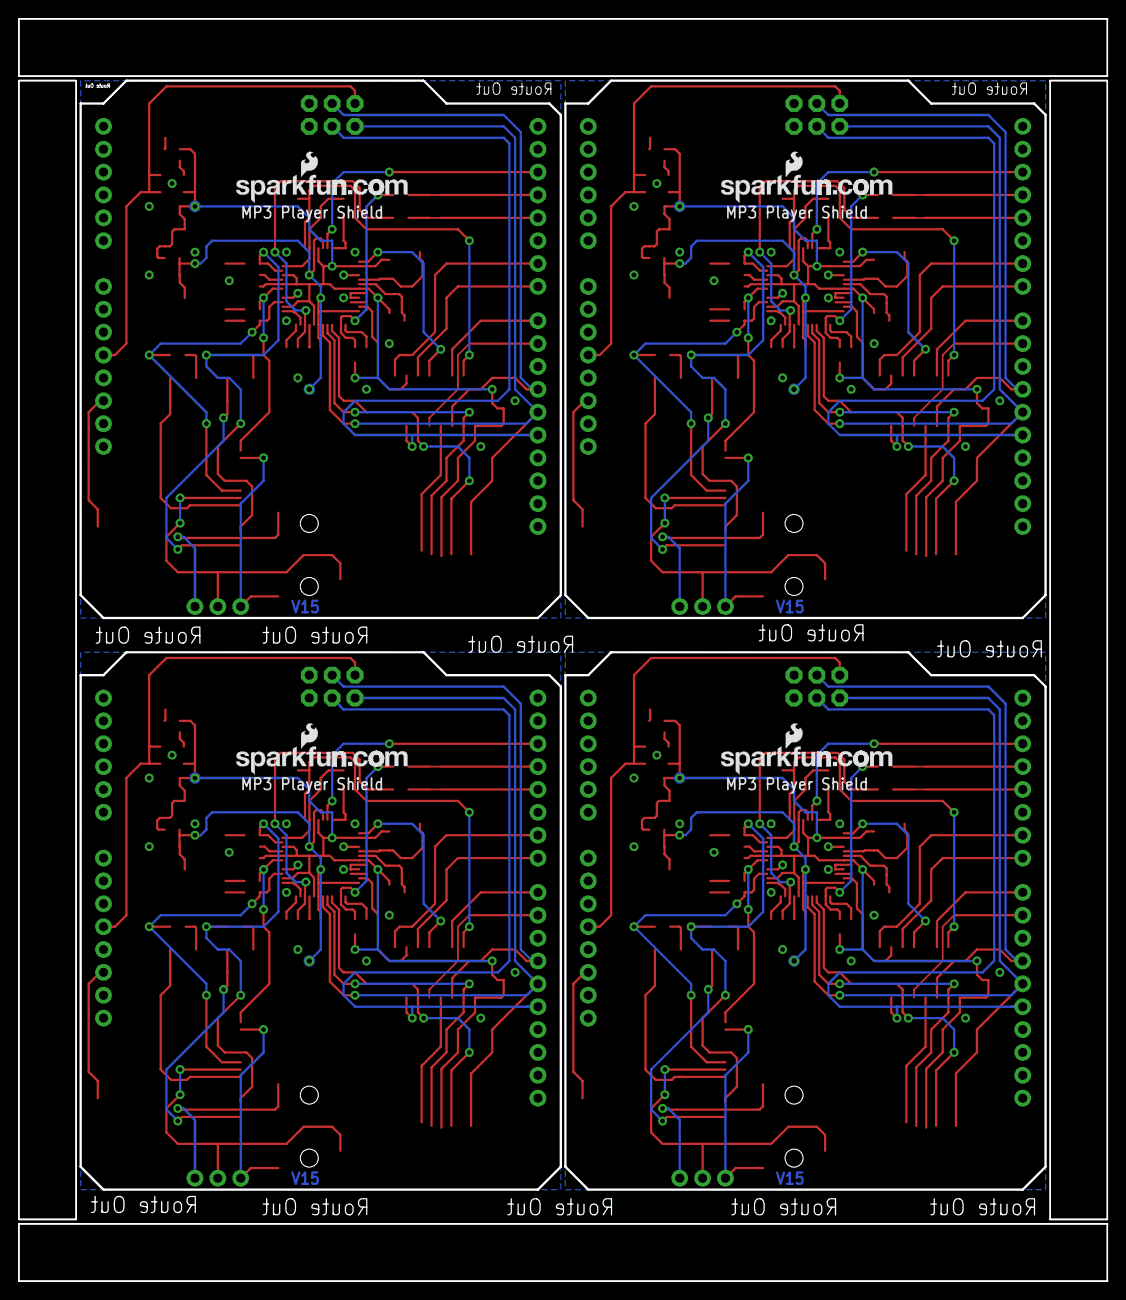
[picture p32: board MP3-Shield-Panel-v15.brd from below]

Board: 2 copper layers, 120.9 x 140.2 mm, 243 parts (12 on the bottom side), 188 nets.

Parts:
C1, C6, C17, C18, C20, C21, C35, C36, C38, C39, C53, C54, C56, C57, C71, C72: 10uF; EIA3216
C2, C5, C7, C13, C14, C15, C16, C19, C22, C30, C31, C32, C33, C34, C37, C40, C48, C49, C50, C51, C52, C55, C58, C66, C67, C68, C69, C70: 0.1uF; 0603-CAP
C3, C8, C23, C24, C41, C42, C59, C60: 22pF; 0603-CAP
C4, C29, C47, C65: 470pF; 0603-CAP
C9, C25, C43, C61: 1.0uF; 0603-CAP
C10, C11, C26, C27, C44, C45, C62, C63: 10nF; 0603-CAP
C12, C28, C46, C64: 47nF; 0603-CAP
E$1: FIDUCIAL-1.5X3
E$4, E$5: FIDUCIAL-1X2
J1, J2, J3, J4: ISP/SPI; 2X3
JP1, JP2, JP5, JP7: AUDIO-JACK-3.5MM-SMD
JP3, JP4, JP6, JP8: Optional; 1X03
LED1, LED2, LED3, LED4: Power; LED-0603
LOGO1, LOGO3, LOGO5, LOGO7: OSHW-LOGOS; OSHW-LOGO-S
LOGO2, LOGO4, LOGO6, LOGO8: SFE_LOGO_NAME_FLAME.1_INCH; SFE_LOGO_NAME_FLAME_.1
Q1, Q2, Q3, Q4: 12.288MHz; CRYSTAL-SMD-5X3
R1, R18, R38, R56: 1M; 0603-RES
R2, R3, R4, R5, R10, R11, R12, R19, R20, R23, R27, R28, R29, R30, R39, R40, R41, R45, R46, R47, R48, R57, R58, R59, R63, R64, R65, R66: 100k; 0603-RES
R6, R7, R24, R25, R42, R43, R60, R61: 20; 0603-RES
R8, R17, R37, R55: 330; 0603-RES
R9, R26, R44, R62: 10; 0603-RES
R13, R14, R31, R32, R49, R50, R67, R68: 1K; 0603-RES
R15, R16, R33, R34, R51, R52, R69, R70: 10K; 0603-RES
R21, R22, R35, R36, R53, R54, R71, R72: 470; 0603-RES
S1, S2, S3, S4: Reset; TACTILE_SWITCH_SMD
SJ1, SJ2, SJ6, SJ7, SJ11, SJ12, SJ16, SJ17: NC; SJ_2S-TRACE
SJ3, SJ8, SJ13, SJ18: AC Coupling L; PAD-JUMPER-3-2OF3_NC_BY_PASTE_YES_SILK_FULL_BOX
SJ4, SJ9, SJ14, SJ19: AC Coupling R; PAD-JUMPER-3-2OF3_NC_BY_PASTE_YES_SILK_FULL_BOX
SJ5, SJ10, SJ15, SJ20: AC Coupling Gnd; PAD-JUMPER-3-2OF3_NC_BY_PASTE_YES_SILK_FULL_BOX
TP1, TP2, TP3, TP4, TP5, TP6, TP7, TP8: PAD.03X.05
U1, U5, U13, U19: 3.3V; SOT23-5
U2, U12, U18, U24: ARDUINO_R3_SHIELD; UNO_R3_SHIELD
U3, U8, U14, U20: VS1053; LQFP-48
U4, U9, U15, U21: 1.8V; SC70
U6, U10, U16, U22: USD-SOCKET; MICRO-SD-SOCKET-PP
U7, U11, U17, U23: 74HC4050 LVL CONVERTER; SO016
U$1, U$2, U$4, U$5, U$6, U$7, U$10, U$11: FIDUCIAL1X2; FIDUCIAL-1X2
U$3, U$8, U$9, U$12: LOGO-SFENEW; SFE-NEW-WEBLOGO

Connections:
1.8V: C1.A, C2.1, C16.1, TP2.P$1, U3.5, U3.7, U3.24, U3.31, U4.5
1.8V1: C21.A, C22.1, C33.1, TP4.P$1, U8.5, U8.7, U8.24, U8.31, U9.5
1.8V2: C39.A, C40.1, C51.1, TP6.P$1, U14.5, U14.7, U14.24, U14.31, U15.5
1.8V3: C57.A, C58.1, C69.1, TP8.P$1, U20.5, U20.7, U20.24, U20.31, U21.5
3.3V: C5.1, C6.A, C7.1, C13.1, C14.1, C15.1, R2.2, R8.2, TP1.P$1, U1.5, U3.6, U3.14, U3.19, U3.32, U3.38, U3.43, U3.45, U4.1, U4.3, U6.4, U7.1
3.3V1: C19.1, C20.A, C30.1, C31.1, C32.1, C34.1, R17.2, R19.2, TP3.P$1, U5.5, U8.6, U8.14, U8.19, U8.32, U8.38, U8.43, U8.45, U9.1, U9.3, U10.4, U11.1
3.3V2: C37.1, C38.A, C48.1, C49.1, C50.1, C52.1, R37.2, R39.2, TP5.P$1, U13.5, U14.6, U14.14, U14.19, U14.32, U14.38, U14.43, U14.45, U15.1, U15.3, U16.4, U17.1
3.3V3: C55.1, C56.A, C66.1, C67.1, C68.1, C70.1, R55.2, R57.2, TP7.P$1, U19.5, U20.6, U20.14, U20.19, U20.32, U20.38, U20.43, U20.45, U21.1, U21.3, U22.4, U23.1
5V-GPIO1: SJ1.2, U2.D4
5V-GPIO2: SJ7.2, U12.D4
5V-GPIO3: SJ12.2, U18.D4
5V-GPIO4: SJ17.2, U24.D4
5V-MIDI-RX: SJ2.1, U2.D3
5V-MIDI-RX1: SJ6.1, U12.D3
5V-MIDI-RX2: SJ11.1, U18.D3
5V-MIDI-RX3: SJ16.1, U24.D3
5V-MOSI: J1.4, U2.D11, U7.3
5V-MOSI1: J2.4, U11.3, U12.D11
5V-MOSI2: J3.4, U17.3, U18.D11
5V-MOSI3: J4.4, U23.3, U24.D11
5V-MP3-CS: U2.D6, U7.9
5V-MP3-CS1: U11.9, U12.D6
5V-MP3-CS2: U17.9, U18.D6
5V-MP3-CS3: U23.9, U24.D6
5V-MP3-DCS: U2.D7, U7.11
5V-MP3-DCS1: U11.11, U12.D7
5V-MP3-DCS2: U17.11, U18.D7
5V-MP3-DCS3: U23.11, U24.D7
5V-MP3-RST: U2.D8, U7.14
5V-MP3-RST1: U11.14, U12.D8
5V-MP3-RST2: U17.14, U18.D8
5V-MP3-RST3: U23.14, U24.D8
5V-SCK: J1.3, U2.D13, U7.7
5V-SCK1: J2.3, U11.7, U12.D13
5V-SCK2: J3.3, U17.7, U18.D13
5V-SCK3: J4.3, U23.7, U24.D13
5V-SD-CS: U2.D9, U7.5
5V-SD-CS1: U11.5, U12.D9
5V-SD-CS2: U17.5, U18.D9
5V-SD-CS3: U23.5, U24.D9
ARST: S2.3, U2.RES
ARST1: S1.3, U12.RES
ARST2: S3.3, U18.RES
ARST3: S4.3, U24.RES
G1: R3.2, U3.9, U3.10, U3.11, U3.12
G2: R4.2, U3.25
G3: R20.2, U8.9, U8.10, U8.11, U8.12
G4: R29.2, U8.25
G5: R40.2, U14.9, U14.10, U14.11, U14.12
G6: R47.2, U14.25
G7: R58.2, U20.9, U20.10, U20.11, U20.12
G8: R65.2, U20.25
GBUF: R9.2, SJ5.3, U3.42
GBUF1: R26.2, SJ10.3, U8.42
GBUF2: R44.2, SJ15.3, U14.42
GBUF3: R62.2, SJ20.3, U20.42
GND: C1.C, C2.2, C3.1, C4.2, C5.2, C6.C, C7.2, C8.1, C9.1, C10.2, C11.2, C12.2, C13.2, C14.2, C15.2, C16.2, J1.6, LED1.C, R3.1, R4.1, R5.1, R10.1, R11.1, R12.1, R15.2, R16.2, S2.1, SJ5.1, U1.2, U2.GND@0, U2.GND@1, U2.GND@2, U3.4, U3.16, U3.20, U3.21, U3.22, U3.35, U3.37, U3.40, U3.41, U3.47, U4.2, U6.6, U6.CD1, U6.CD2, U6.GND1, U6.GND3, U7.8
GND1: C19.2, C20.C, C21.C, C22.2, C23.1, C24.1, C25.1, C26.2, C27.2, C28.2, C29.2, C30.2, C31.2, C32.2, C33.2, C34.2, J2.6, LED2.C, R20.1, R23.1, R27.1, R28.1, R29.1, R30.1, R33.2, R34.2, S1.1, SJ10.1, U5.2, U8.4, U8.16, U8.20, U8.21, U8.22, U8.35, U8.37, U8.40, U8.41, U8.47, U9.2, U10.6, U10.CD1, U10.CD2, U10.GND1, U10.GND3, U11.8, U12.GND@0, U12.GND@1, U12.GND@2
GND2: C37.2, C38.C, C39.C, C40.2, C41.1, C42.1, C43.1, C44.2, C45.2, C46.2, C47.2, C48.2, C49.2, C50.2, C51.2, C52.2, J3.6, LED3.C, R40.1, R41.1, R45.1, R46.1, R47.1, R48.1, R51.2, R52.2, S3.1, SJ15.1, U13.2, U14.4, U14.16, U14.20, U14.21, U14.22, U14.35, U14.37, U14.40, U14.41, U14.47, U15.2, U16.6, U16.CD1, U16.CD2, U16.GND1, U16.GND3, U17.8, U18.GND@0, U18.GND@1, U18.GND@2
GND3: C55.2, C56.C, C57.C, C58.2, C59.1, C60.1, C61.1, C62.2, C63.2, C64.2, C65.2, C66.2, C67.2, C68.2, C69.2, C70.2, J4.6, LED4.C, R58.1, R59.1, R63.1, R64.1, R65.1, R66.1, R69.2, R70.2, S4.1, SJ20.1, U19.2, U20.4, U20.16, U20.20, U20.21, U20.22, U20.35, U20.37, U20.40, U20.41, U20.47, U21.2, U22.6, U22.CD1, U22.CD2, U22.GND1, U22.GND3, U23.8, U24.GND@0, U24.GND@1, U24.GND@2
GPIO0: R11.2, U3.33
GPIO1: R10.2, R14.1, U3.34
GPIO2: R28.2, U8.33
GPIO3: R27.2, R32.1, U8.34
GPIO4: R12.2, U3.36
GPIO5: R30.2, U8.36
GPIO6: R46.2, U14.33
GPIO7: R45.2, R50.1, U14.34
GPIO8: R48.2, U14.36
GPIO9: R64.2, U20.33
GPIO10: R63.2, R68.1, U20.34
GPIO11: R66.2, U20.36
LEFT: R7.2, R21.2, SJ3.3, U3.46
LEFT1: R25.2, R35.2, SJ8.3, U8.46
LEFT2: R43.2, R53.2, SJ13.3, U14.46
LEFT3: R61.2, R71.2, SJ18.3, U20.46
MIDI-RX: R2.1, R13.2, U3.26
MIDI-RX1: R19.1, R31.2, U8.26
MIDI-RX2: R39.1, R49.2, U14.26
MIDI-RX3: R57.1, R67.2, U20.26
MISO: J1.1, U2.D12, U3.30, U6.7
MISO1: J2.1, U8.30, U10.7, U12.D12
MISO2: J3.1, U14.30, U16.7, U18.D12
MISO3: J4.1, U20.30, U22.7, U24.D12
MOSI: U3.29, U6.3, U7.2
MOSI1: U8.29, U10.3, U11.2
MOSI2: U14.29, U16.3, U17.2
MOSI3: U20.29, U22.3, U23.2
MP3-CS: U3.23, U7.10
MP3-CS1: U8.23, U11.10
MP3-CS2: U14.23, U17.10
MP3-CS3: U20.23, U23.10
MP3-DCS: U3.13, U7.12
MP3-DCS1: U8.13, U11.12
MP3-DCS2: U14.13, U17.12
MP3-DCS3: U20.13, U23.12
MP3-DREQ: U2.D2, U3.8
MP3-DREQ1: U8.8, U12.D2
MP3-DREQ2: U14.8, U18.D2
MP3-DREQ3: U20.8, U24.D2
MP3-RST: R5.2, U3.3, U7.15
MP3-RST1: R23.2, U8.3, U11.15
MP3-RST2: R41.2, U14.3, U17.15
MP3-RST3: R59.2, U20.3, U23.15
unnamed: LED2.A, R17.1
unnamed: C12.1, R9.1
unnamed: C10.1, R6.1
unnamed: R14.2, SJ1.1
unnamed: C11.1, R7.1
unnamed: LED1.A, R8.1
unnamed: C23.2, Q2.3, R18.2, U8.18
unnamed: R13.1, SJ2.2
unnamed: C3.2, Q1.3, R1.2, U3.18
unnamed: C8.2, Q1.1, R1.1, U3.17
unnamed: C24.2, Q2.1, R18.1, U8.17
unnamed: JP1.SLEEVE, JP3.1, SJ5.2
unnamed: JP1.RING, JP3.2, SJ4.2
unnamed: JP1.TIP, JP3.3, SJ3.2
unnamed: C28.1, R26.1
unnamed: C27.1, R25.1
unnamed: C18.A, R22.1
unnamed: C26.1, R24.1
unnamed: C17.A, R21.1
unnamed: C29.1, U5.4
unnamed: R31.1, SJ6.2
unnamed: R32.2, SJ7.1
unnamed: C36.A, R36.1
unnamed: C35.A, R35.1
unnamed: JP2.SLEEVE, JP4.1, SJ10.2
unnamed: JP2.RING, JP4.2, SJ9.2
unnamed: JP2.TIP, JP4.3, SJ8.2
unnamed: LED3.A, R37.1
unnamed: C41.2, Q3.3, R38.2, U14.18
unnamed: C42.2, Q3.1, R38.1, U14.17
unnamed: C46.1, R44.1
unnamed: C45.1, R43.1
unnamed: C44.1, R42.1
unnamed: C47.1, U13.4
unnamed: R49.1, SJ11.2
unnamed: R50.2, SJ12.1
unnamed: C54.A, R54.1
unnamed: C53.A, R53.1
unnamed: JP5.SLEEVE, JP6.1, SJ15.2
unnamed: JP5.RING, JP6.2, SJ14.2
unnamed: JP5.TIP, JP6.3, SJ13.2
unnamed: LED4.A, R55.1
unnamed: C59.2, Q4.3, R56.2, U20.18
unnamed: C60.2, Q4.1, R56.1, U20.17
unnamed: C64.1, R62.1
unnamed: C63.1, R61.1
unnamed: C62.1, R60.1
unnamed: C65.1, U19.4
unnamed: R67.1, SJ16.2
unnamed: R68.2, SJ17.1
unnamed: C72.A, R72.1
unnamed: C71.A, R71.1
unnamed: JP7.SLEEVE, JP8.1, SJ20.2
unnamed: JP7.RING, JP8.2, SJ19.2
unnamed: JP7.TIP, JP8.3, SJ18.2
unnamed: C4.1, U1.4
RCAP: C9.2, U3.44
RCAP1: C25.2, U8.44
RCAP2: C43.2, U14.44
RCAP3: C61.2, U20.44
RIGHT: R6.2, R22.2, SJ4.3, U3.39
RIGHT1: R24.2, R36.2, SJ9.3, U8.39
RIGHT2: R42.2, R54.2, SJ14.3, U14.39
RIGHT3: R60.2, R72.2, SJ19.3, U20.39
SCK: U3.28, U6.5, U7.6
SCK1: U8.28, U10.5, U11.6
SCK2: U14.28, U16.5, U17.6
SCK3: U20.28, U22.5, U23.6
SD-CS: U6.2, U7.4
SD-CS1: U10.2, U11.4
SD-CS2: U16.2, U17.4
SD-CS3: U22.2, U23.4
SPKR-L: C17.C, R15.1, SJ3.1
SPKR-L1: C35.C, R33.1, SJ8.1
SPKR-L2: C53.C, R51.1, SJ13.1
SPKR-L3: C71.C, R69.1, SJ18.1
SPKR-R: C18.C, R16.1, SJ4.1
SPKR-R1: C36.C, R34.1, SJ9.1
SPKR-R2: C54.C, R52.1, SJ14.1
SPKR-R3: C72.C, R70.1, SJ19.1
VCC: J1.2, U1.1, U1.3, U2.5V
VCC1: J2.2, U5.1, U5.3, U12.5V
VCC2: J3.2, U13.1, U13.3, U18.5V
VCC3: J4.2, U19.1, U19.3, U24.5V
