mc2-coruna/LACNLC-PistaBaile/(commit log)

2017-06-30 Initial commit
    Documentos del detector de rayos cósmicos en forma de pista de baile
    para la exposición La Astronomía Como nos la Cuentan
2017-06-30 cambios en el ciclo de escaneo de los GEIGER
    Resuelto problema con el ciclo de lectura. Ahora lee los GEIGER unas
    100 veces antes de escrutar el BT. Queda pendiente de limpiar y ordenar
2017-07-01 Cambios en la secuencia de muestreo de los tubos Geiger. Las funciones auxiliares ahora están en un fichero aparte.
2017-07-02 Muchos ajustes para que funcione completamente. Pendiente de limpieza y orden
2017-08-04 Anotaciones nueva versión
    Para acordarnos de actualizar la versión
2017-08-05 Cambios en los nombres de los ficheros
2017-08-05 Documentación final de la parte Arduino
    Estos son los ficheros arduino que están instalados a fecha de la
    inauguración (21/7/2017)
    Se incluye un resumen de comando para los módulos bluetooth,
    instrucciones para emparejarlos.
2017-09-05 Añadidos esquemas de la parte electrónica
    [Placa cablead_suelo.brd, Placa cablead_suelo.sch, Placa_control_suelo.brd, Placa_control_suelo.sch]
2017-09-24 Ajustes para bajarle la sensibilidad
2020-08-27 Info BT extra
    Actualizar información para emparejar los módulos BT
2020-08-27 Ordenar y agrupar información
    [MP3-Shield-Panel-v15.brd, Pista Baile.FCStd, Placa cablead_suelo.brd, Placa cablead_suelo.sch, Placa cableado.fzz, Placa_control_suelo.brd, Placa_control_suelo.sch, SparkFunMP3Shield.brd]
2020-10-10 cambio de volumen general
    bajada de volumen
